DLedzianowski/badanie-ogniw-projekt-inzynierski/hardware/PCB/models/pin_jumper_2.54mm.step

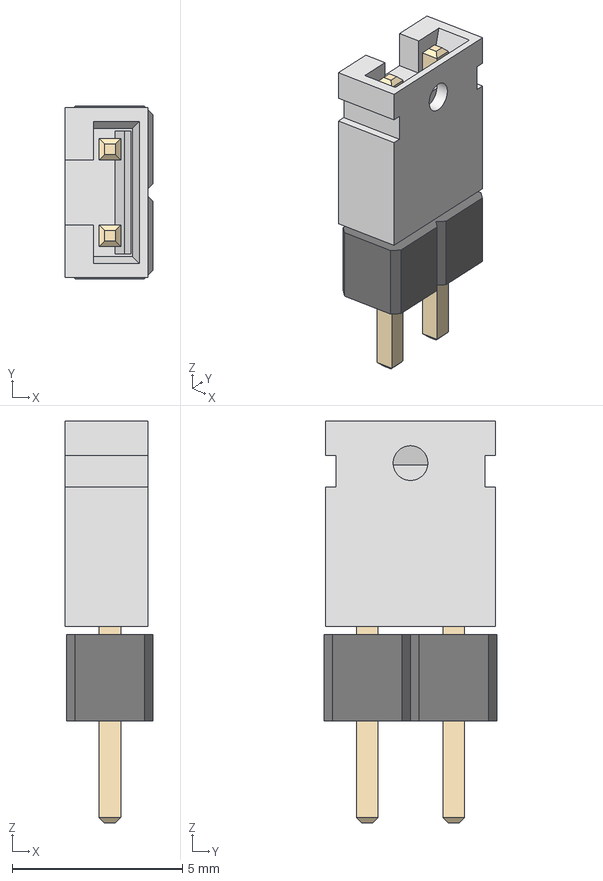
[picture p1: CAD file, 2025-12-05]
hardware/PCB/models/pin_jumper_2.54mm.step
2.59 x 5.08 x 11.8 mm
26m5017_142270-1
PinHeader_1x02_P254mm_Vertical
