DLedzianowski/badanie-ogniw-projekt-inzynierski/hardware/PCB/models/Fuse Holder.step

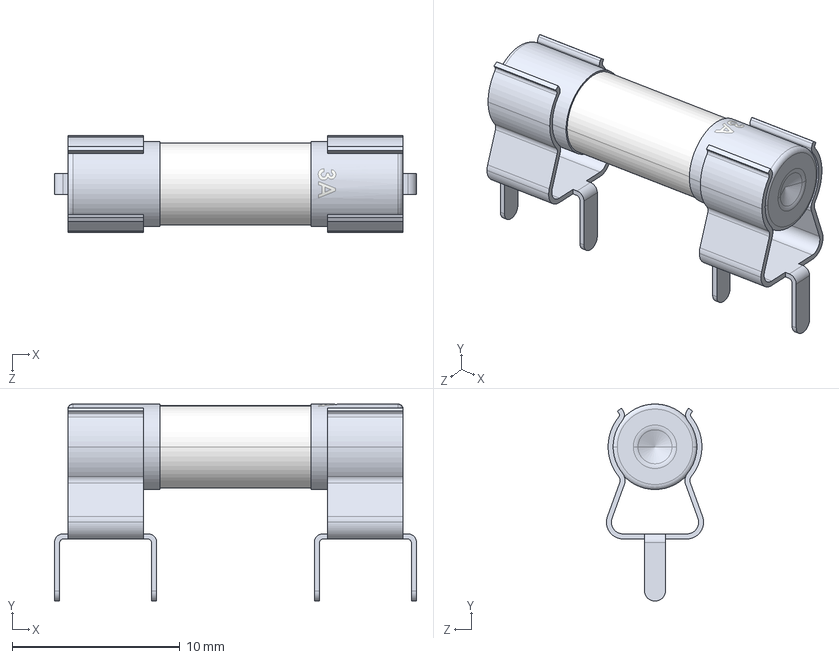
[picture p2: CAD file, 2025-12-04]
hardware/PCB/models/Fuse Holder.step
21.6 x 11.8 x 5.80 mm
Fuse Clip x 2
3A Fuse
