DLedzianowski/badanie-ogniw-projekt-inzynierski/hardware/PCB/inz.kicad_pcb

## KiCad design hardware/PCB/inz.kicad_pcb (2026-01-27)

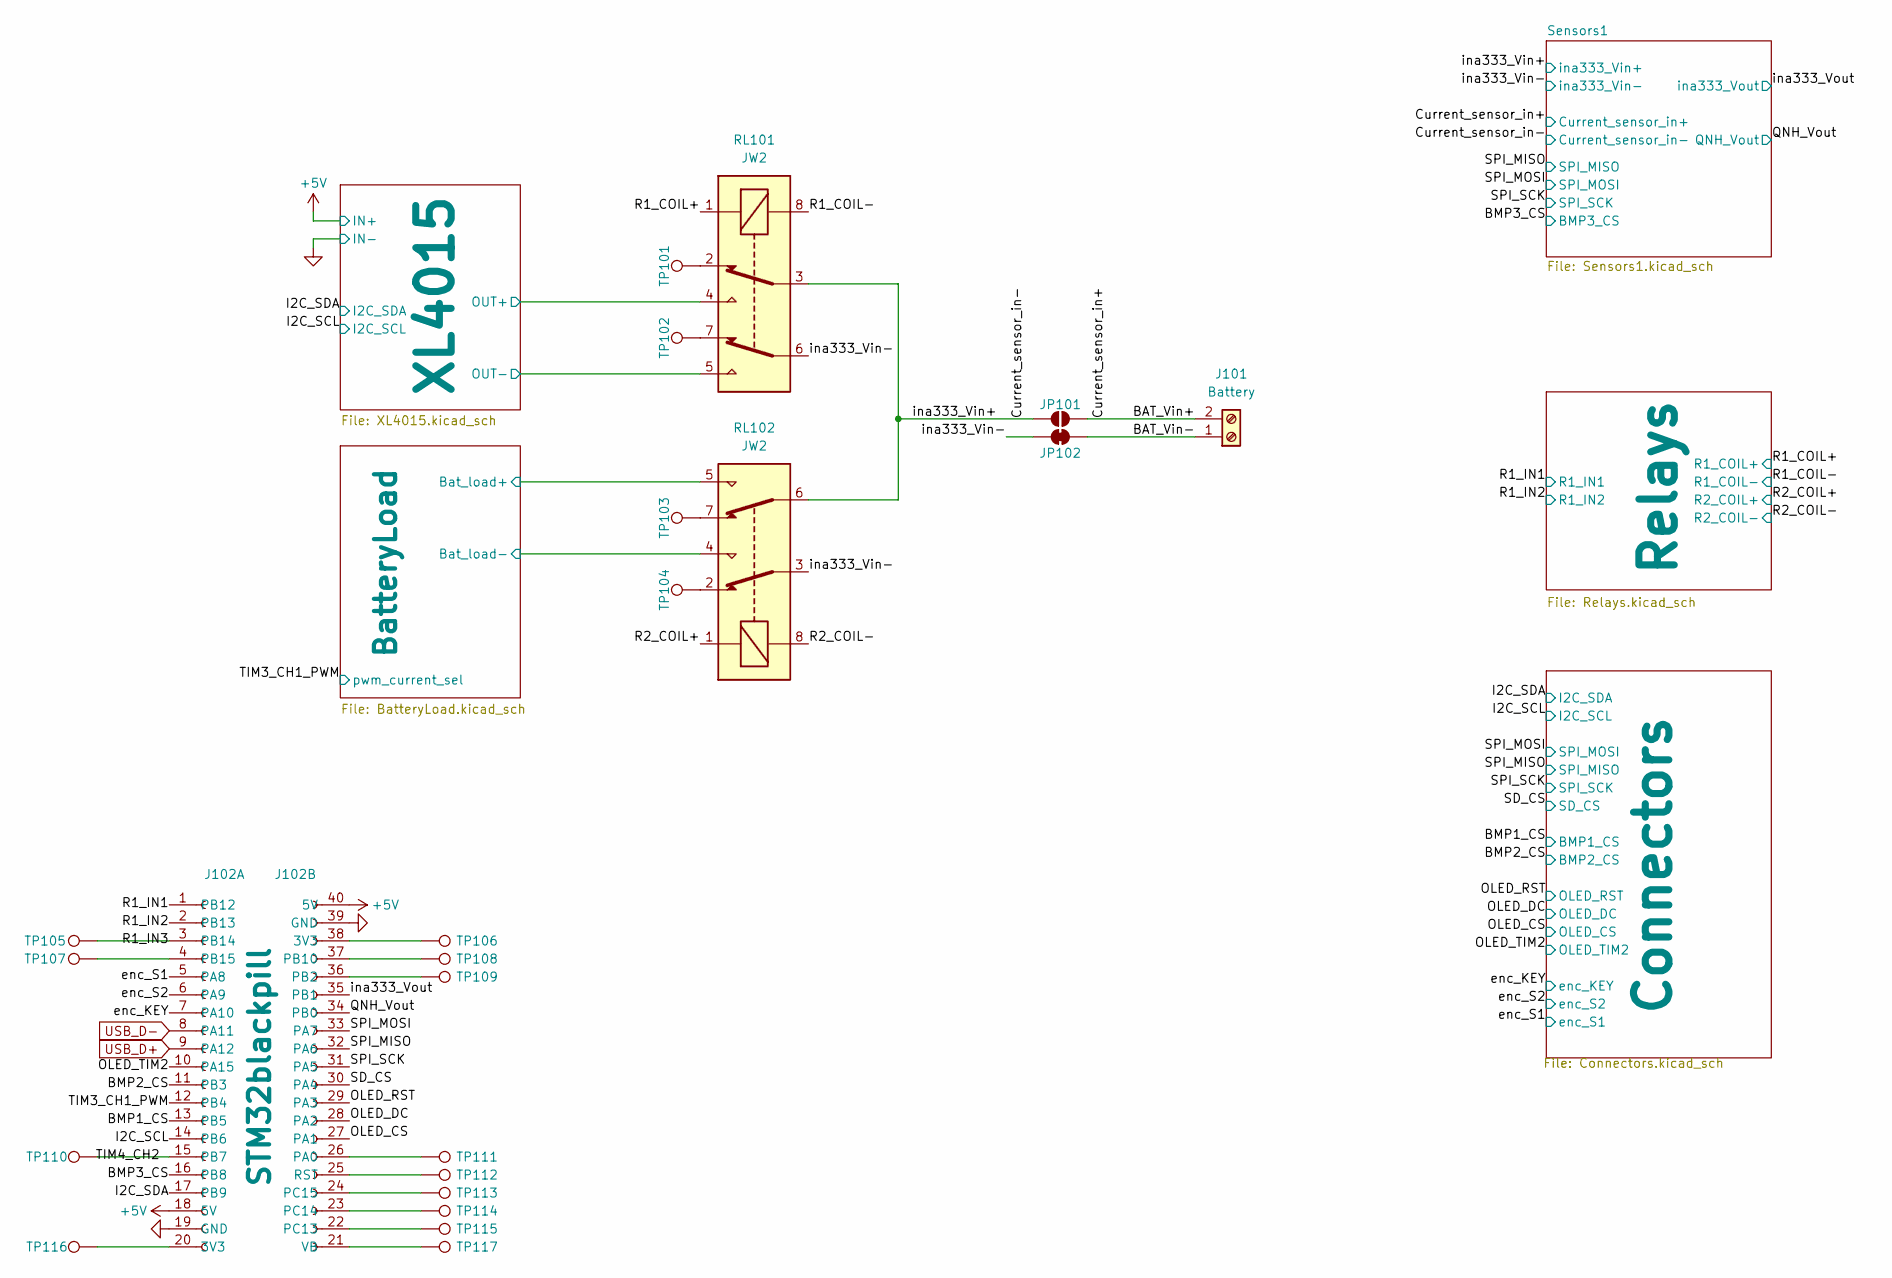
[picture p3: schematic inz.kicad_sch, Stanowisko do badania parametrów pracy ogniw Li-Ion Li-Pol]

Parts:
J101: Battery; TerminalBlock_Phoenix_MKDS-1,5-2_1x02_P5.00mm_Horizontal
J102: STM32blackpill; MFR Part ICSockets-40P; JLCPCB Part C2332
JP101: SolderJumper_2_Open; SolderJumper-2_P1.3mm_Open_TrianglePad1.0x1.5mm
JP102: Jumper_2_Bridged; PinHeader_1x02_P2.54mm_Vertical
RL101, RL102: JW2; Relay_DPDT_Panasonic_JW2; MFR Part JW2SN-DC5V
TP101, TP102, TP103, TP104, TP105, TP106, TP107, TP108, TP109, TP110, TP111, TP112, TP113, TP114, TP115, TP116, TP117: TestPoint; TestPoint_THTPad_D1.5mm_Drill0.7mm

Connections:
+5V: J102.18 (5V), J102.40 (5V), RL101.1, RL102.1; also elsewhere on the board
/BAT_Vin+: J101.2, JP101.1 (A); also elsewhere on the board
/BAT_Vin-: J101.1, JP102.2 (B)
/BMP1_CS: J102.13 (PB5); also elsewhere on the board
/BMP2_CS: J102.11 (PB3); also elsewhere on the board
/BMP3_CS: J102.16 (PB8); also elsewhere on the board
/BatteryLoad/Bat_load+: RL102.5; also elsewhere on the board
/Current_sensor_in-: JP101.2 (B), RL101.3, RL102.6; also elsewhere on the board
/I2C_SCL: J102.14 (PB6); also elsewhere on the board
/I2C_SDA: J102.17 (PB9); also elsewhere on the board
/OLED_CS: J102.27 (PA1); also elsewhere on the board
/OLED_DC: J102.28 (PA2); also elsewhere on the board
/OLED_RST: J102.29 (PA3); also elsewhere on the board
/OLED_TIM2: J102.10 (PA15); also elsewhere on the board
/QNH_Vout: J102.34 (PB0); also elsewhere on the board
/R1_COIL-: RL101.8; also elsewhere on the board
/R1_IN1: J102.1 (PB12); also elsewhere on the board
/R1_IN2: J102.2 (PB13); also elsewhere on the board
/R1_IN3: J102.3 (PB14), TP105.1
/R2_COIL-: RL102.8; also elsewhere on the board
/SD_CS: J102.30 (PA4); also elsewhere on the board
/SPI_MISO: J102.32 (PA6); also elsewhere on the board
/SPI_MOSI: J102.33 (PA7); also elsewhere on the board
/SPI_SCK: J102.31 (PA5); also elsewhere on the board
/TIM3_CH1_PWM: J102.12 (PB4); also elsewhere on the board
/TIM4_CH2: J102.15 (PB7), TP110.1
/XL4015/OUT+: RL101.4; also elsewhere on the board
/XL4015/OUT-: RL101.5; also elsewhere on the board
/enc_KEY: J102.7 (PA10); also elsewhere on the board
/enc_S1: J102.5 (PA8); also elsewhere on the board
/enc_S2: J102.6 (PA9); also elsewhere on the board
/ina333_Vin-: JP102.1 (A), RL101.6, RL102.3; also elsewhere on the board
/ina333_Vout: J102.35 (PB1); also elsewhere on the board
GND: J102.19 (GND), J102.39 (GND), RL102.4; also elsewhere on the board
unnamed: J102.20 (3V3), TP116.1
unnamed: J102.4 (PB15), TP107.1
unnamed: J102.38 (3V3), TP106.1
unnamed: J102.26 (PA0), TP111.1
unnamed: J102.36 (PB2), TP109.1
unnamed: J102.37 (PB10), TP108.1
unnamed: J102.22 (PC13), TP115.1
unnamed: J102.23 (PC14), TP114.1
unnamed: J102.24 (PC15), TP113.1
unnamed: J102.25 (RST), TP112.1
unnamed: J102.21 (VB), TP117.1
unnamed: RL101.2, TP101.1
unnamed: RL101.7, TP102.1
unnamed: RL102.2, TP104.1
unnamed: RL102.7, TP103.1
USB_D+: J102.9 (PA12); also elsewhere on the board
USB_D-: J102.8 (PA11); also elsewhere on the board

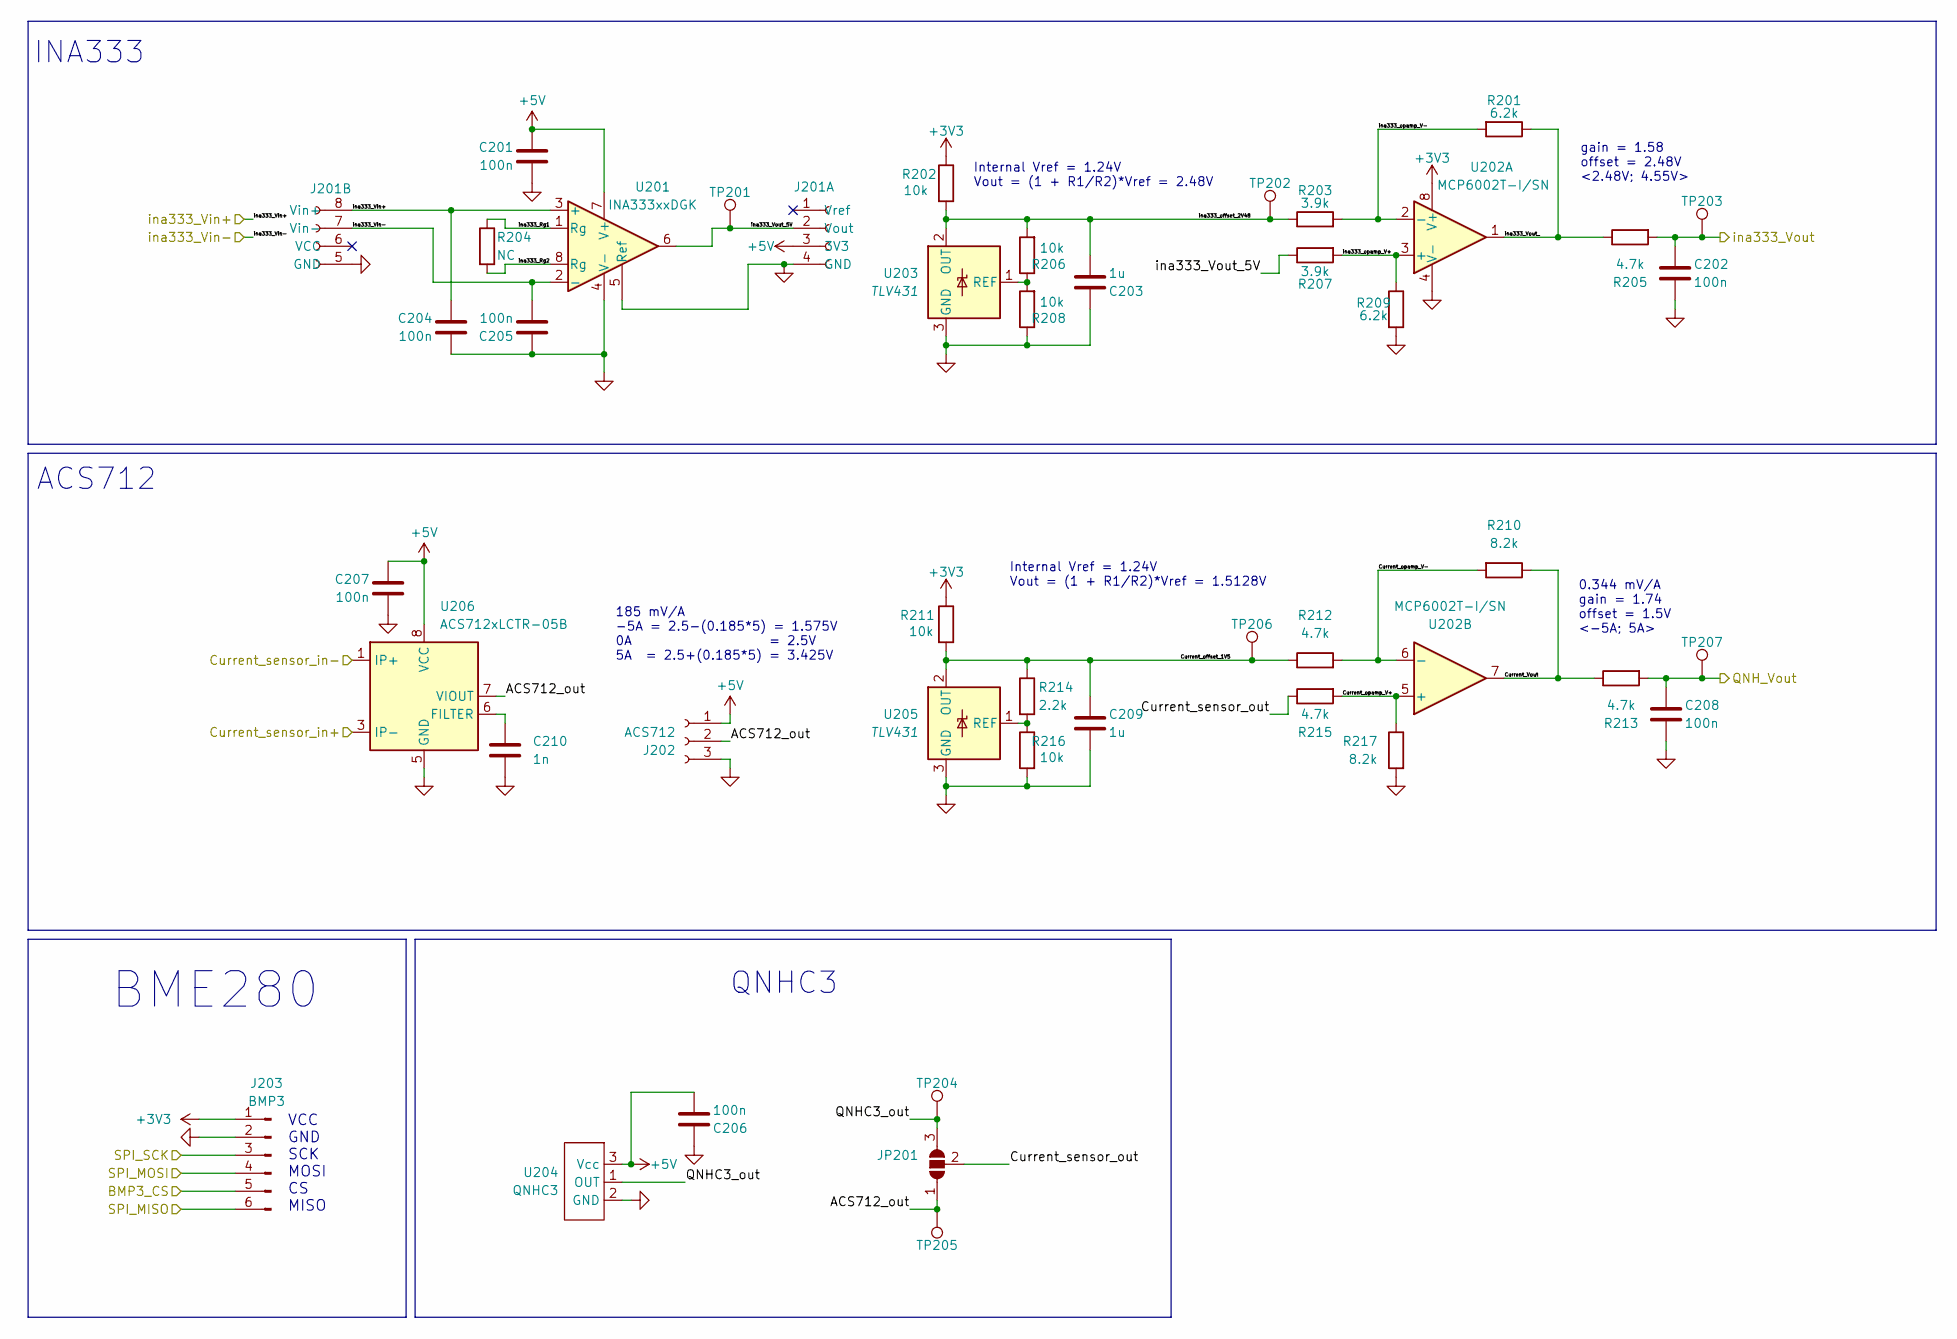
[picture p4: schematic Sensors1.kicad_sch, Stanowisko do badania parametrów pracy ogniw Li-Ion Li-Pol]

Parts:
C201, C202, C204, C205, C206, C207, C208: 100n; C_0805_2012Metric; MFR Part CL21B104KCFNNNE; JLCPCB Part C28233
C203, C209: 1u; C_0805_2012Metric; MFR Part CL21B105KBFNNNE; JLCPCB Part C28323
C210: 1n; C_0805_2012Metric; MFR Part CL21B102KBCNNNC; JLCPCB Part C46653
J201: ina333; board_ina333
J202: ACS712; PinHeader_1x03_P2.54mm_Vertical
J203: BMP3; PinHeader_1x06_P2.54mm_Vertical
JP201: SolderJumper_3_Open; SolderJumper-3_P2.0mm_Open_TrianglePad1.0x1.5mm_NumberLabels
R201, R209: 6.2k; R_0805_2012Metric; MFR Part 0805W8F6201T5E; JLCPCB Part C17767
R202, R206, R208, R211, R216: 10k; R_0805_2012Metric; MFR Part 0805W8F1002T5E; JLCPCB Part C17414
R203, R207: 3.9k; R_0805_2012Metric; MFR Part 0805W8F3901T5E; JLCPCB Part C17614
R204: NC; R_0805_2012Metric
R205, R212, R213, R215: 4.7k; R_0805_2012Metric; MFR Part 0805W8F4701T5E; JLCPCB Part C17673
R210, R217: 8.2k; R_0805_2012Metric; MFR Part 0805W8F8201T5E; JLCPCB Part C17828
R214: 2.2k; R_0805_2012Metric; MFR Part 0805W8F2201T5E; JLCPCB Part C17520
TP201, TP202, TP203, TP204, TP205, TP206, TP207: TestPoint; TestPoint_THTPad_D1.5mm_Drill0.7mm
U201: INA333xxDGK; VSSOP-8_3x3mm_P0.65mm; MFR Part INA333AIDGKT; JLCPCB Part C2057648
U202: MCP6002T-I/SN; SOIC-8_3.9x4.9mm_P1.27mm; MFR Part MCP6002T-I/SN; JLCPCB Part C7377
U203, U205: TLV431; SOT-23; MFR Part TLV431AIDBZR; JLCPCB Part C56765
U204: QNHC3
U206: ACS712xLCTR-05B; SOIC-8_3.9x4.9mm_P1.27mm; MFR Part ACS712ELCTR-05B-T; JLCPCB Part C44471

Connections:
+3V3: J203.1, R202.1, R211.1, U202.8 (V+); also elsewhere on the board
+5V: C201.1, C206.2, C207.1, J201.3 (3V3), J202.1, U201.7 (V+), U204.3 (Vcc), U206.8 (VCC); also elsewhere on the board
/BAT_Vin+: U206.3 (IP-), U206.4 (IP-); also elsewhere on the board
/BMP3_CS: J203.5; also elsewhere on the board
/Current_sensor_in-: C204.1, J201.8 (Vin+), U201.3 (+), U206.1 (IP+), U206.2 (IP+); also elsewhere on the board
/QNH_Vout: C208.1, R213.2, TP207.1; also elsewhere on the board
/SPI_MISO: J203.6; also elsewhere on the board
/SPI_MOSI: J203.4; also elsewhere on the board
/SPI_SCK: J203.3; also elsewhere on the board
/Sensors1/ACS712_out: J202.2, JP201.1 (A), TP205.1, U206.7 (VIOUT)
/Sensors1/Current_Vout: R210.1, R213.1, U202.7
/Sensors1/Current_offset_1V5: C209.1, R211.2, R212.1, R214.1, TP206.1, U205.2 (OUT)
/Sensors1/Current_opamp_V+: R215.2, R217.1, U202.5 (+)
/Sensors1/Current_opamp_V-: R210.2, R212.2, U202.6 (-)
/Sensors1/Current_sensor_out: JP201.2 (C), R215.1
/Sensors1/QNHC3_out: JP201.3 (B), TP204.1, U204.1 (OUT)
/Sensors1/ina333_Rg1: R204.1, U201.1 (Rg)
/Sensors1/ina333_Rg2: R204.2, U201.8 (Rg)
/Sensors1/ina333_Vout_: R201.1, R205.1, U202.1
/Sensors1/ina333_Vout_5V: J201.2 (Vout), R207.1, TP201.1, U201.6
/Sensors1/ina333_offset_2V48: C203.2, R202.2, R203.1, R206.2, TP202.1, U203.2 (OUT)
/Sensors1/ina333_opamp_V+: R207.2, R209.1, U202.3 (+)
/Sensors1/ina333_opamp_V-: R201.2, R203.2, U202.2 (-)
/ina333_Vin-: C205.2, J201.7 (Vin-), U201.2 (-); also elsewhere on the board
/ina333_Vout: C202.1, R205.2, TP203.1; also elsewhere on the board
GND: C201.2, C202.2, C203.1, C204.2, C205.1, C206.1, C207.2, C208.2, C209.2, C210.2, J201.4 (GND), J201.5 (GND), J202.3, J203.2, R208.1, R209.2, R216.2, R217.2, U201.4 (V-), U201.5 (Ref), U202.4 (V-), U203.3 (GND), U204.2 (GND), U205.3 (GND), U206.5 (GND); also elsewhere on the board
unnamed: R206.1, R208.2, U203.1 (REF)
unnamed: R214.2, R216.1, U205.1 (REF)
unnamed: C210.1, U206.6 (FILTER)

Notes on the sheet:
BME280
185 mV/A -5A = 2.5-(0.185*5) = 1.575V 0A = 2.5V 5A = 2.5+(0.185*5) = 3.425V
Internal Vref = 1.24V Vout = (1 + R1/R2)*Vref = 2.48V
gain = 1.58 offset = 2.48V <2.48V; 4.55V>
VCC GND SCK MOSI CS MISO
QNHC3
INA333
ACS712
Internal Vref = 1.24V Vout = (1 + R1/R2)*Vref = 1.5128V
0.344 mV/A gain = 1.74 offset = 1.5V <-5A; 5A>

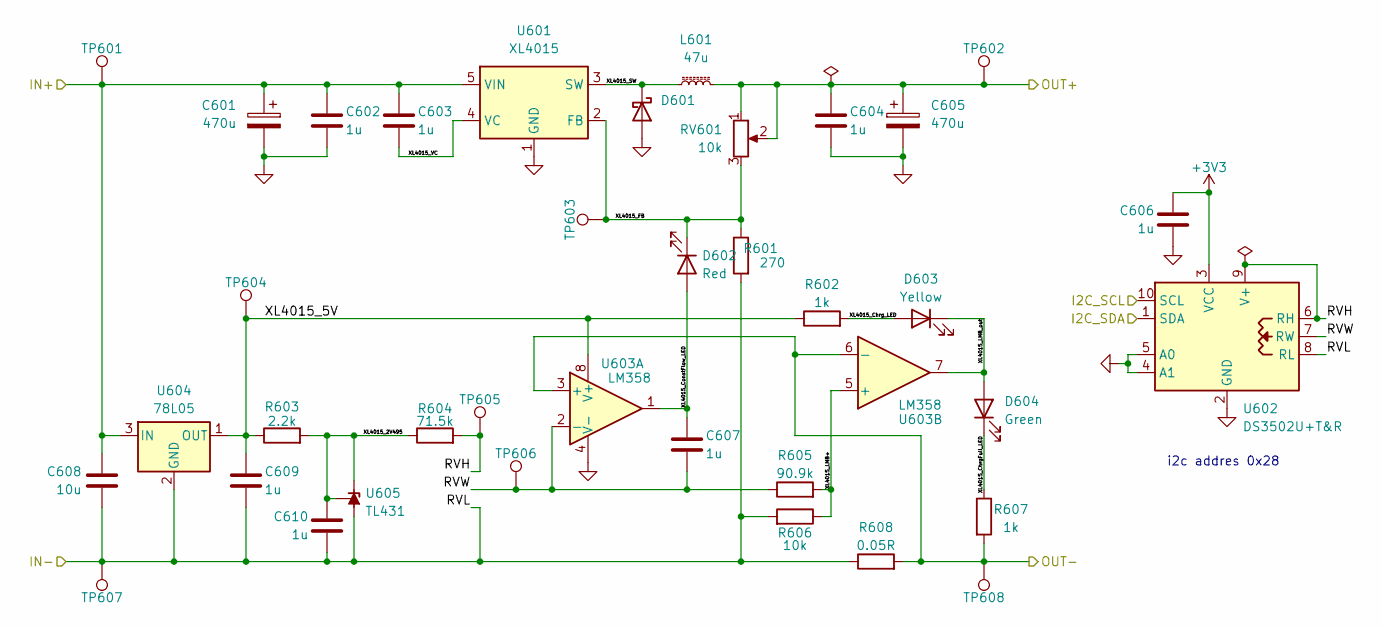
[picture p5: schematic XL4015.kicad_sch, Stanowisko do badania parametrów pracy ogniw Li-Ion Li-Pol]

Parts:
C601, C605: 470u; C_Elec_10x10.2; MFR Part RVT1E471M1010; JLCPCB Part C3351
C602, C603, C604, C606, C607, C609, C610: 1u; C_0805_2012Metric; MFR Part CL21B105KBFNNNE; JLCPCB Part C28323
C608: 10u; C_1206_3216Metric; MFR Part CL31A106KOHNNNE; JLCPCB Part C1849
D601: MBRD1045; D_SMA; MFR Part C22452; JLCPCB Part C22452
D602: Red; LED_0805_2012Metric; MFR Part NCD0805R1; JLCPCB Part C84256
D603: Yellow; LED_0805_2012Metric; MFR Part KT-0805Y; JLCPCB Part C2296
D604: Green; LED_0805_2012Metric; MFR Part KT-0805G; JLCPCB Part C2297
L601: 47u; L_Toroid_Vertical_L16.0mm_W8.0mm_P7.62mm; MFR Part XR050125TS470MVL8; JLCPCB Part C18213949
R601: 270; R_0805_2012Metric; MFR Part 0805W8F2700T5E; JLCPCB Part C17590
R602, R607: 1k; R_0805_2012Metric; MFR Part 0805W8F1001T5E; JLCPCB Part C17513
R603: 2.2k; R_0805_2012Metric; MFR Part 0805W8F2201T5E; JLCPCB Part C17520
R604: 71.5k; R_0805_2012Metric; MFR Part 0805W8F7152T5E; JLCPCB Part C17811
R605: 90.9k; R_0805_2012Metric; MFR Part 0805W8F9092T5E; JLCPCB Part C17860
R606: 10k; R_0805_2012Metric; MFR Part 0805W8F1002T5E; JLCPCB Part C17414
R608: 0.05R; R_2512_6332Metric; MFR Part 25121WF500MT4E; JLCPCB Part C127698
RV601: 10k; Potentiometer_Bourns_3299W_Vertical
TP601, TP602, TP603, TP604, TP605, TP606, TP607, TP608: TestPoint; TestPoint_THTPad_D1.5mm_Drill0.7mm
U601: XL4015; TO-263-5_TabPin3; MFR Part XL4015E1; JLCPCB Part C51661
U602: DS3502U+T&R; TSSOP-10_3x3mm_P0.5mm; MFR Part DS3502U+T&R; JLCPCB Part C2649363
U603: LM358; SOIC-8_3.9x4.9mm_P1.27mm; MFR Part LM358DR2G; JLCPCB Part C7950
U604: 78L05; SOT-89-3; MFR Part 78L05G-AB3-R; JLCPCB Part C71136
U605: TL431; SOT-23-3; MFR Part TL431BQDBZR; JLCPCB Part C190245

Connections:
+3V3: C606.1, U602.3 (VCC); also elsewhere on the board
+5V: C601.1, C602.1, C603.1, C608.1, TP601.1, U601.5 (VIN), U604.3 (IN); also elsewhere on the board
/I2C_SCL: U602.10 (SCL); also elsewhere on the board
/I2C_SDA: U602.1 (SDA); also elsewhere on the board
/XL4015/OUT+: C604.1, C605.1, L601.2, RV601.1, RV601.2, TP602.1; also elsewhere on the board
/XL4015/OUT-: R607.2, R608.2, TP608.1, U603.3 (+), U603.6 (-); also elsewhere on the board
/XL4015/RVH: R604.2, TP605.1, U602.6 (RH), U602.9 (V+)
/XL4015/RVW: C607.2, R605.1, TP606.1, U602.7 (RW), U603.2 (-)
/XL4015/XL4015_2V495: C610.1, R603.2, R604.1, U605.1 (K), U605.2 (REF)
/XL4015/XL4015_5V: C609.1, R602.1, R603.1, TP604.1, U603.8 (V+), U604.1 (OUT)
/XL4015/XL4015_ChrgFull_LED: D604.1 (K), R607.1
/XL4015/XL4015_Chrg_LED: D603.2 (A), R602.2
/XL4015/XL4015_ConstFlow_LED: C607.1, D602.2 (A), U603.1
/XL4015/XL4015_FB: D602.1 (K), R601.1, RV601.3, TP603.1, U601.2 (FB)
/XL4015/XL4015_LMB+: R605.2, R606.1, U603.5 (+)
/XL4015/XL4015_LMB_out: D603.1 (K), D604.2 (A), U603.7
/XL4015/XL4015_SW: D601.1 (K), L601.1, U601.3 (SW)
/XL4015/XL4015_VC: C603.2, U601.4 (VC)
GND: C601.2, C602.2, C604.2, C605.2, C606.2, C608.2, C609.2, C610.2, D601.2 (A), R601.2, R606.2, R608.1, TP607.1, U601.1 (GND), U602.2 (GND), U602.4 (A1), U602.5 (A0), U602.8 (RL), U603.4 (V-), U604.2 (GND), U605.3 (A); also elsewhere on the board

Notes on the sheet:
i2c addres 0x28

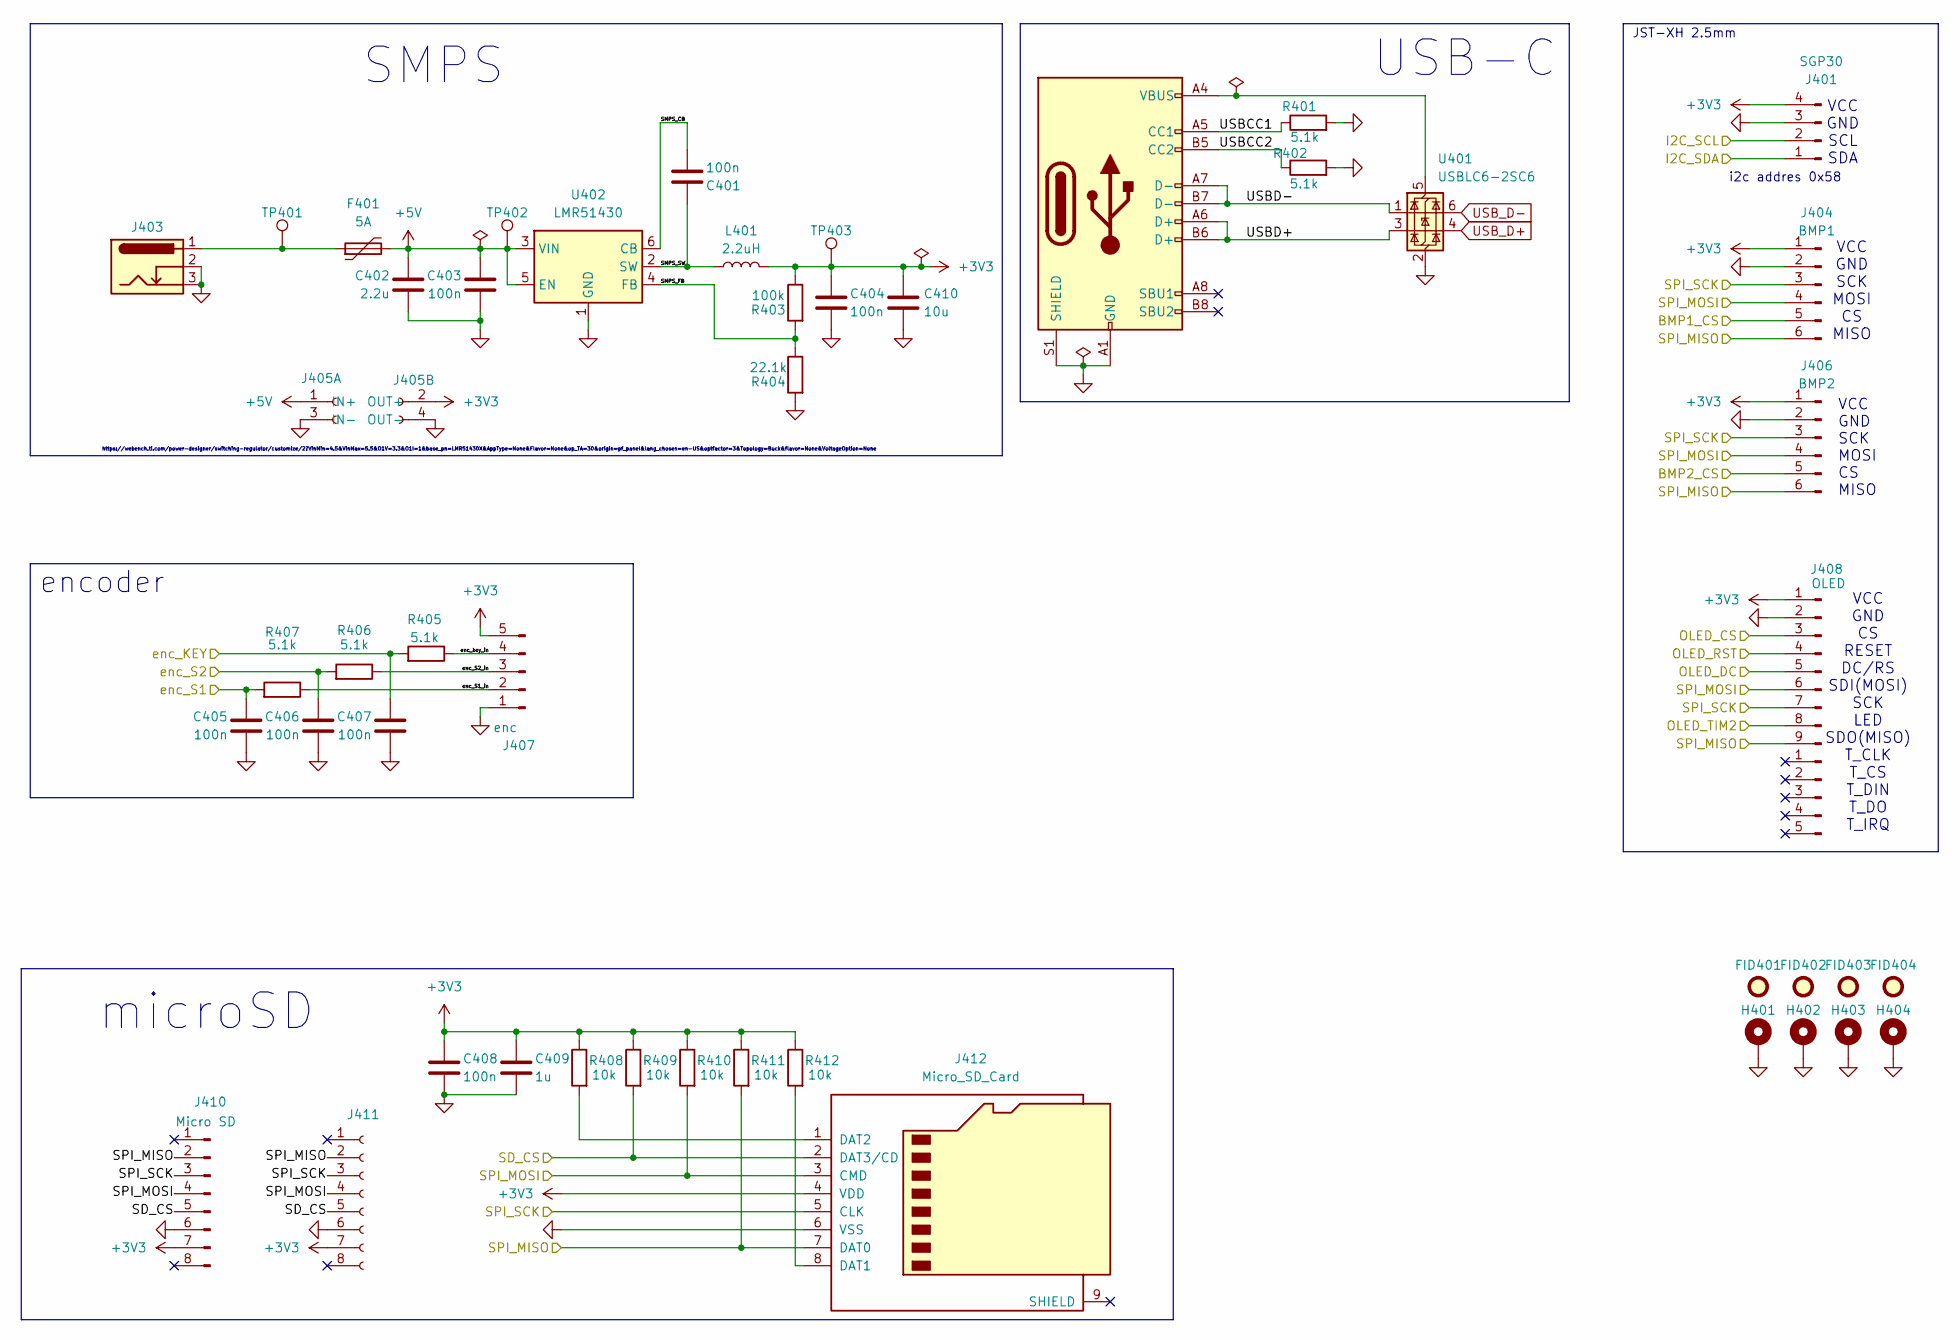
[picture p6: schematic Connectors.kicad_sch, Stanowisko do badania parametrów pracy ogniw Li-Ion Li-Pol]

Parts:
C401, C405, C406, C407, C408: 100n; C_0805_2012Metric; MFR Part CL21B104KCFNNNE; JLCPCB Part C28233
C402: 2.2u; C_0805_2012Metric; MFR Part CL21A225KBQNNNE; JLCPCB Part C377773
C403, C404: 100n; C_0805_2012Metric; MFR Part CL21B104KBCNNNC; JLCPCB Part C1711
C409: 1u; C_0805_2012Metric; MFR Part CL21B105KBFNNNE; JLCPCB Part C28323
C410: 10u; C_1206_3216Metric; MFR Part CL31A106KOHNNNE; JLCPCB Part C1849
F401: 5A; Fuseholder_Clip-5x20mm
FID401, FID402, FID403, FID404: Fiducial; Fiducial_1mm_Mask2mm
H401, H402, H403, H404: MountingHole_Pad; MountingHole_3.2mm_M3_Pad
J401: SGP30; JST_XH_B4B-XH-A_1x04_P2.50mm_Vertical; MFR Part B4B-XH-A(LF)(SN); JLCPCB Part C144395
J402: USBC; USB_C_16P; MFR Part TYPE-C-31-M-48; JLCPCB Part C47817612
J403: 5V; BarrelJack_GCT_DCJ200-10-A_Horizontal; MFR Part DC-005H-D020; JLCPCB Part C5155559
J404: BMP1; JST_XH_B6B-XH-A_1x06_P2.50mm_Vertical; MFR Part B6B-XH-A(LF)(SN); JLCPCB Part C144397
J405: board_step-down
J406: BMP2; JST_XH_B6B-XH-A_1x06_P2.50mm_Vertical; MFR Part B6B-XH-A(LF)(SN); JLCPCB Part C144397
J407: enc; JST_XH_B5B-XH-A_1x05_P2.50mm_Vertical; MFR Part B5B-XH-A(LF)(SN); JLCPCB Part C157991
J408: OLED; JST_XH_B9B-XH-A_1x09_P2.50mm_Vertical; MFR Part B9B-XH-A(LF)(SN); JLCPCB Part C157966
J409: Conn_01x05_Pin; JST_XH_B5B-XH-A_1x05_P2.50mm_Vertical
J410: Micro SD; board_smd_sd
J411: Micro SD2; PinHeader_1x08_P2.54mm_Vertical
J412: Micro_SD_Card; microSD; MFR Part TF-021B-H265; JLCPCB Part C498185
L401: 2.2uH; SMD,10.4x10.3mm; MFR Part SXN(Shun Xiang Nuo Elec); JLCPCB Part C10164
R401, R402, R405, R406, R407: 5.1k; R_0805_2012Metric; MFR Part 0805W8F5101T5E; JLCPCB Part C27834
R403: 100k; R_0805_2012Metric; MFR Part 0805W8F1003T5E; JLCPCB Part C149504
R404: 22.1k; R_0805_2012Metric; MFR Part 0805W8F2212T5E; JLCPCB Part C17552
R408, R409, R410, R411, R412: 10k; R_0805_2012Metric; MFR Part 0805W8F1002T5E; JLCPCB Part C17414
TP401, TP402, TP403: TestPoint; TestPoint_THTPad_D1.5mm_Drill0.7mm
U401: USBLC6-2SC6; SOT-23-6; MFR Part USBLC6-2SC6; JLCPCB Part C7519
U402: LMR51430; SOT-23-6; MFR Part LMR51430XDDCR; JLCPCB Part C5185863

Connections:
+3V3: C404.1, C408.1, C409.1, C410.1, J401.4, J404.1, J405.2 (OUT+), J406.1, J407.5, J408.1, J410.7, J411.7, J412.4 (VDD), L401.2, R403.1, R408.1, R409.1, R410.1, R411.1, R412.1, TP403.1; also elsewhere on the board
+5V: C402.1, C403.1, F401.2, J405.1 (IN+), TP402.1, U402.3 (VIN), U402.5 (EN); also elsewhere on the board
/BMP1_CS: J404.5; also elsewhere on the board
/BMP2_CS: J406.5; also elsewhere on the board
/Connectors/SMPS_CB: C401.2, U402.6 (CB)
/Connectors/SMPS_FB: R403.2, R404.1, U402.4 (FB)
/Connectors/SMPS_SW: C401.1, L401.1, U402.2 (SW)
/Connectors/USBCC1: J402.A5 (CC1), R401.1
/Connectors/USBCC2: J402.B5 (CC2), R402.1
/Connectors/USBD+: J402.A6 (D+), J402.B6 (D+), U401.3 (I/O2)
/Connectors/USBD-: J402.A7 (D-), J402.B7 (D-), U401.1 (I/O1)
/Connectors/enc_S1_in: J407.2, R407.1
/Connectors/enc_S2_in: J407.3, R406.1
/Connectors/enc_key_in: J407.4, R405.1
/I2C_SCL: J401.2; also elsewhere on the board
/I2C_SDA: J401.1; also elsewhere on the board
/OLED_CS: J408.3; also elsewhere on the board
/OLED_DC: J408.5; also elsewhere on the board
/OLED_RST: J408.4; also elsewhere on the board
/OLED_TIM2: J408.8; also elsewhere on the board
/SD_CS: J410.5, J411.5, J412.2 (DAT3/CD), R409.2; also elsewhere on the board
/SPI_MISO: J404.6, J406.6, J408.9, J410.2, J411.2, J412.7 (DAT0), R411.2; also elsewhere on the board
/SPI_MOSI: J404.4, J406.4, J408.6, J410.4, J411.4, J412.3 (CMD), R410.2; also elsewhere on the board
/SPI_SCK: J404.3, J406.3, J408.7, J410.3, J411.3, J412.5 (CLK); also elsewhere on the board
/enc_KEY: C407.1, R405.2; also elsewhere on the board
/enc_S1: C405.1, R407.2; also elsewhere on the board
/enc_S2: C406.1, R406.2; also elsewhere on the board
GND: C402.2, C403.2, C404.2, C405.2, C406.2, C407.2, C408.2, C409.2, C410.2, H401.1, H402.1, H403.1, H404.1, J401.3, J402.A1 (GND), J402.A12 (GND), J402.B1 (GND), J402.B12 (GND), J402.S1 (SHIELD), J403.2, J403.3, J404.2, J405.3 (IN-), J405.4 (OUT-), J406.2, J407.1, J408.2, J410.6, J411.6, J412.6 (VSS), R401.2, R402.2, R404.2, U401.2 (GND), U402.1 (GND); also elsewhere on the board
unnamed: F401.1, J403.1, TP401.1
unnamed: J412.8 (DAT1), R412.2
unnamed: J412.1 (DAT2), R408.2
unnamed: J402.A4 (VBUS), J402.A9 (VBUS), J402.B4 (VBUS), J402.B9 (VBUS), U401.5 (VBUS)
USB_D+: U401.4 (I/O2); also elsewhere on the board
USB_D-: U401.6 (I/O1); also elsewhere on the board

Notes on the sheet:
VCC GND SCL SDA
SMPS
microSD
VCC GND SCK MOSI CS MISO
i2c addres 0x58
USB-C
encoder
https://webench.ti.com/power-designer/switching-regulator/customize/2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
JST-XH 2.5mm
VCC GND CS RESET DC/RS SDI(MOSI) SCK LED SDO(MISO) T_CLK T_CS T_DIN T_DO T_IRQ
VCC GND SCK MOSI CS MISO

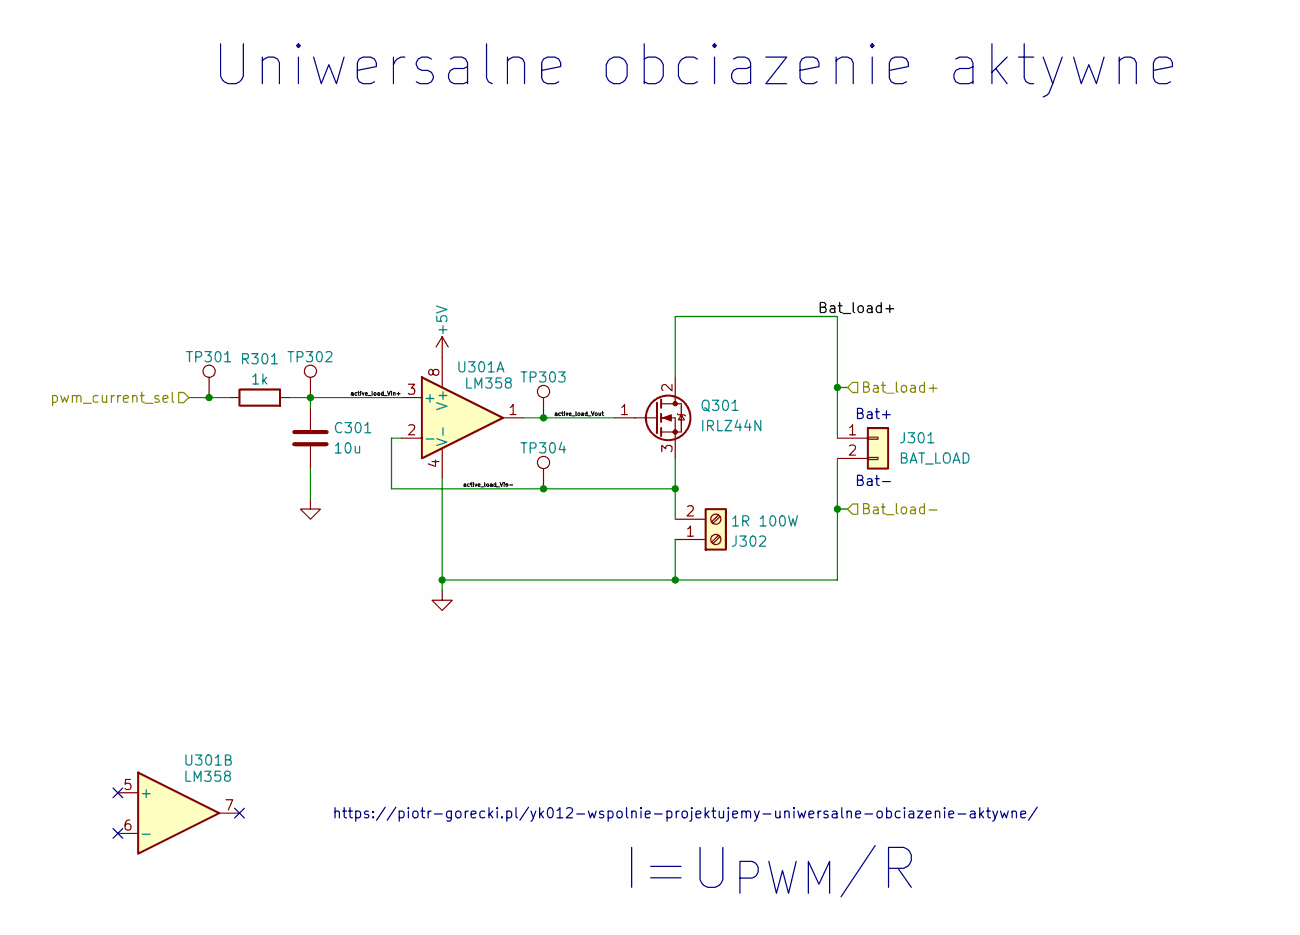
[picture p7: schematic BatteryLoad.kicad_sch, Stanowisko do badania parametrów pracy ogniw Li-Ion Li-Pol]

Parts:
C301: 10u; C_1206_3216Metric; MFR Part CL31A106KOHNNNE; JLCPCB Part C1849
J301: BAT_LOAD; TerminalBlock_MaiXu_MX126-5.0-02P_1x02_P5.00mm
J302: 1R 100W; TerminalBlock_Phoenix_MKDS-1,5-2_1x02_P5.00mm_Horizontal
Q301: IRLZ44N; TO-220-3_Vertical; MFR Part IRLZ44NPBF; JLCPCB Part C38774
R301: 1k; R_0805_2012Metric; MFR Part 0805W8F1001T5E; JLCPCB Part C17513
TP301, TP302, TP303, TP304: TestPoint; TestPoint_THTPad_D1.5mm_Drill0.7mm
U301: LM358; SOIC-8_3.9x4.9mm_P1.27mm; MFR Part LM358DR2G; JLCPCB Part C7950

Connections:
+5V: U301.8 (V+); also elsewhere on the board
/BatteryLoad/Bat_load+: J301.1, Q301.2 (D); also elsewhere on the board
/BatteryLoad/active_load_Vin+: C301.1, R301.2, TP302.1, U301.3 (+)
/BatteryLoad/active_load_Vin-: J302.2, Q301.3 (S), TP304.1, U301.2 (-)
/BatteryLoad/active_load_Vout: Q301.1 (G), TP303.1, U301.1
/TIM3_CH1_PWM: R301.1, TP301.1; also elsewhere on the board
GND: C301.2, J301.2, J302.1, U301.4 (V-); also elsewhere on the board

Notes on the sheet:
Uniwersalne obciazenie aktywne
Bat-
I=U_{PWM}/R
https://piotr-gorecki.pl/yk012-wspolnie-projektujemy-uniwersalne-obciazenie-aktywne/
Bat+

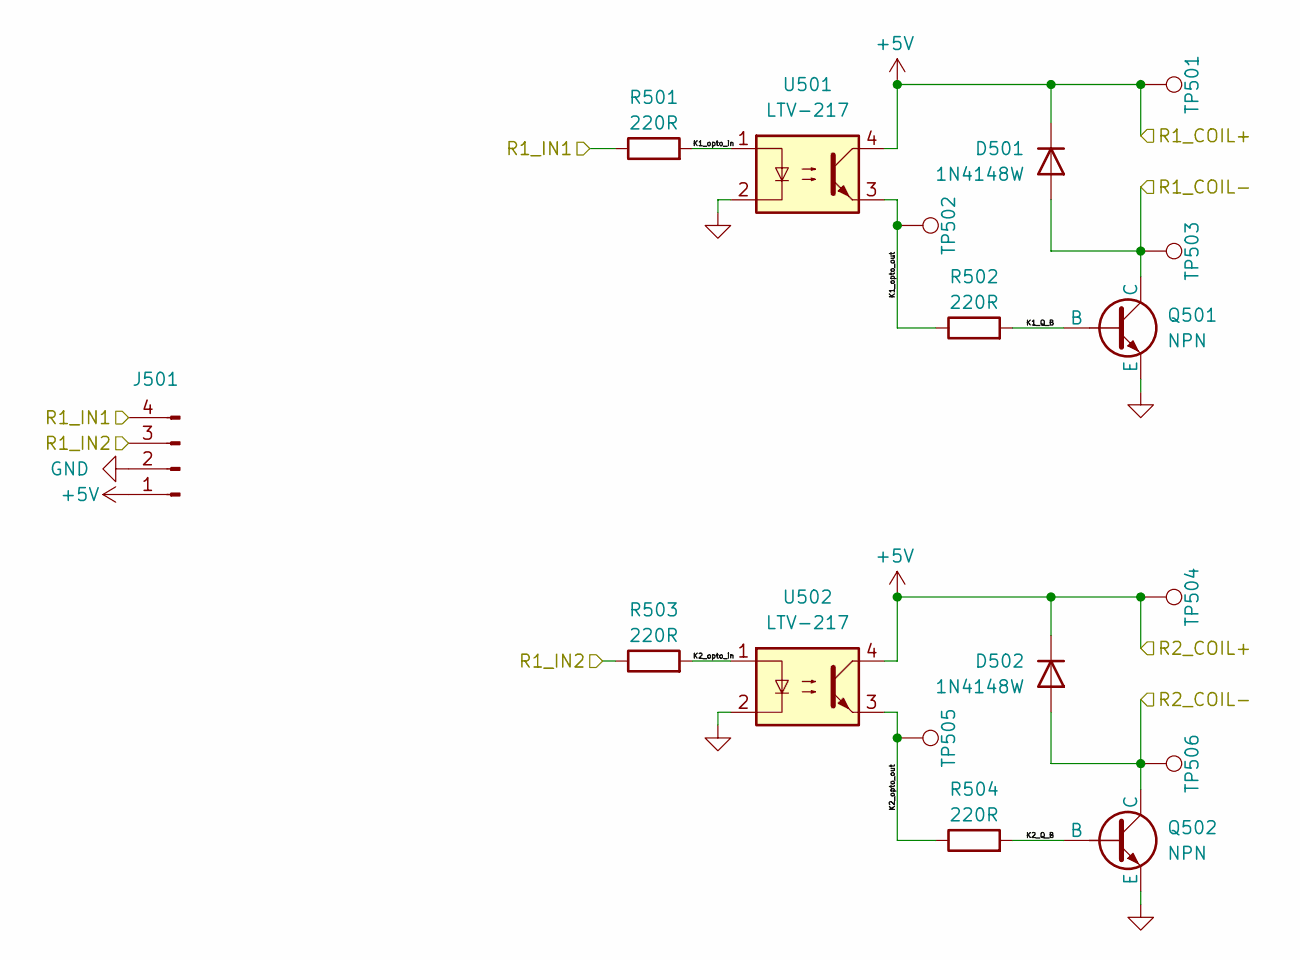
[picture p8: schematic Relays.kicad_sch, Stanowisko do badania parametrów pracy ogniw Li-Ion Li-Pol]

Parts:
D501, D502: 1N4148W; D_SOD-123; MFR Part 1N4148W; JLCPCB Part C81598
J501: Conn_01x04_Pin; PinHeader_1x04_P2.54mm_Vertical
Q501, Q502: NPN; SOT-23; MFR Part MMBT3904(RANGE:100-300); JLCPCB Part C20526
R501, R502, R503, R504: 220R; R_0805_2012Metric; MFR Part 0805W8F2200T5E; JLCPCB Part C17557
TP501, TP502, TP503, TP504, TP505, TP506: TestPoint; TestPoint_THTPad_D1.5mm_Drill0.7mm
U501, U502: LTV-217; SOP-4_4.4x2.6mm_P1.27mm; MFR Part LTV-217-B-G; JLCPCB Part C115450

Connections:
+5V: D501.1 (K), D502.1 (K), J501.1, TP501.1, TP504.1, U501.4, U502.4; also elsewhere on the board
/R1_COIL-: D501.2 (A), Q501.1 (C), TP503.1; also elsewhere on the board
/R1_IN1: J501.4, R501.1; also elsewhere on the board
/R1_IN2: J501.3, R503.1; also elsewhere on the board
/R2_COIL-: D502.2 (A), Q502.1 (C), TP506.1; also elsewhere on the board
/Relays/K1_Q_B: Q501.2 (B), R502.2
/Relays/K1_opto_in: R501.2, U501.1
/Relays/K1_opto_out: R502.1, TP502.1, U501.3
/Relays/K2_Q_B: Q502.2 (B), R504.2
/Relays/K2_opto_in: R503.2, U502.1
/Relays/K2_opto_out: R504.1, TP505.1, U502.3
GND: J501.2, Q501.3 (E), Q502.3 (E), U501.2, U502.2; also elsewhere on the board

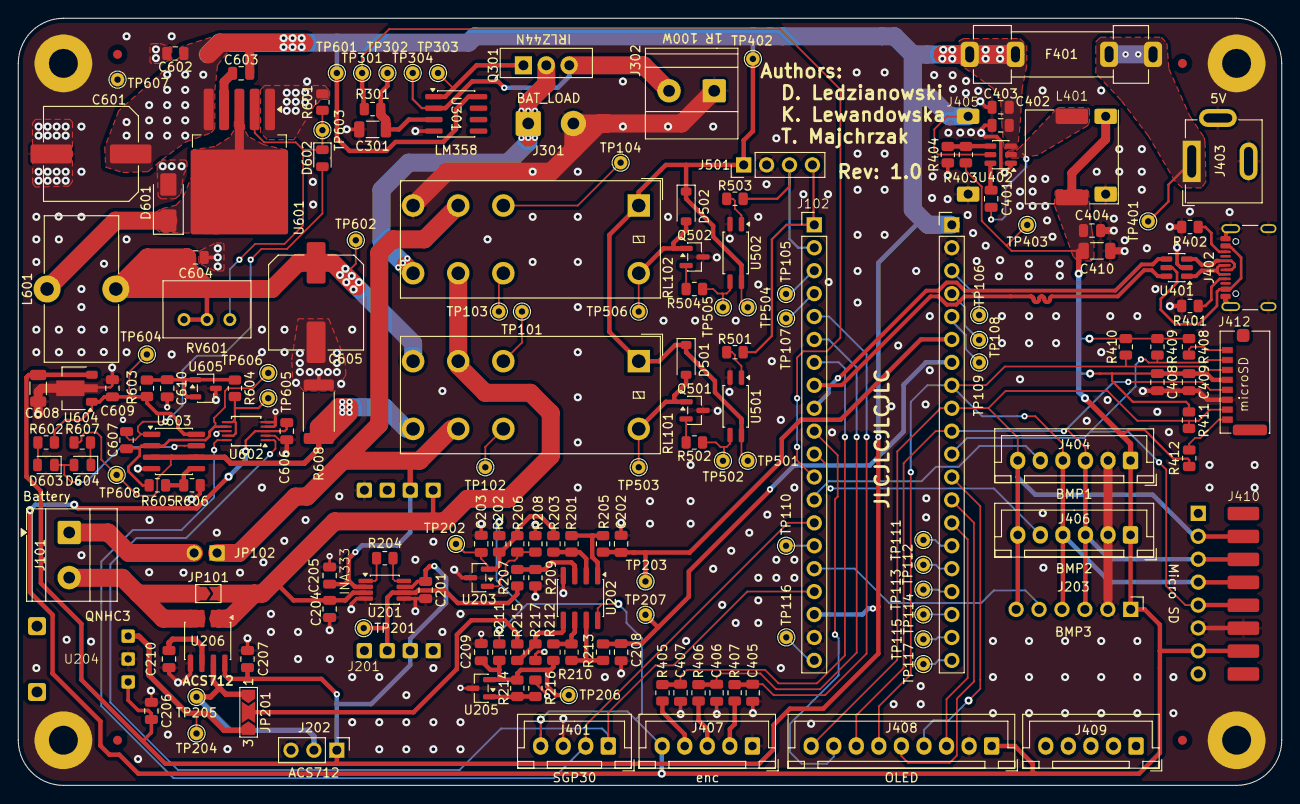
[picture p9: board inz.kicad_pcb from above]

Board: 2 copper layers, 140.0 x 85.0 mm, 180 parts (0 on the bottom side), 104 nets.
