DLedzianowski/badanie-ogniw-projekt-inzynierski/software/STM32CubeIDE/badanie-ogniw-blackpill/Core/Src/main.c

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
/* Includes ------------------------------------------------------------------*/
#include "main.h"
#include "adc.h"
#include "dma.h"
#include "fatfs.h"
#include "i2c.h"
#include "spi.h"
#include "tim.h"
#include "usb_device.h"
#include "gpio.h"

/* USER CODE BEGIN Includes */
#include "usbd_cdc_if.h"
#include "sensors/printf_to_uart.h"
#include "sensors/ILI9341_STM32_Driver.h"
#include "sensors/ILI9341_GFX.h"
#include "sensors/fonts.h"
#include "sensors/BMPXX80.h"
#include "sensors/sensirion_common.h"
#include "sensors/sgp30.h"
#include "logic/user_SDcard.h"
#include "logic/user_OLED.h"
#include "logic/user_fnc.h"

/* USER CODE END Includes */


/* USER CODE BEGIN PV */
struct state st = {
	.current_screen_type = MENU_MAIN,
	.menu_current_ptr = MENU_START,
	.sensor_current = SENSOR_FIRST,
	.battery_state = BATTERY_IDLE,  // BATTERY_IDLE = 0, BATTERY_CHARGING = 1, BATTERY_DISCHARGING = 2
	.auto_mode_current = AUTO_MODE,  // AUTO_MODE = 0, MANUAL_MODE = 1

	.screen_menu_ptr = 0,
	.screen_menu_current = 0,
	.battery_ptr = 0,
	.battery_current = 0,
	.status_ptr = 0,     // BATTERY_IDLE = 0, BATTERY_CHARGING = 1, BATTERY_DISCHARGING = 2
	.status_current = 0, // BATTERY_IDLE = 0, BATTERY_CHARGING = 1, BATTERY_DISCHARGING = 2
	.auto_mode_ptr = 0,     // AUTO_MODE = 0, MANUAL_MODE = 1
	.auto_mode_current = 0, // AUTO_MODE = 0, MANUAL_MODE = 1
	.enc_count = 0,
	.prev_enc_count = 0,
	.enc_offset = 0,
    .set_current_discharge = 0,      // prad rozłaowywania
    .set_current_discharge_prev = 0, // prad rozłaowywania
    .set_current_charge = 0,
    .set_current_charge_prev = 0,
    .get_current_charge = 0,
    .charge_end_current = 0.1,      // minimalny prad ladowania
    .charge_end_current_prev = 0.1, // minimalny prad ladowania
    .discharge_cutoff_voltage = 3.0,      // minimalne napiecie rozladowywania
    .discharge_cutoff_voltage_prev = 3.0, // minimalne napiecie rozladowywania

	.is_screen_menu = true,
	.screen_clear = true,
};
struct sensors s = {0};

const char* menu[SCREENS_MENU_NUM] = {
	"Start",
	//"Typ baterii",
	//"Prad adowania",
	"Min. prad adowania",
	"Min. napiecie roz.",
	"Prad rozadowania",
	"Status",
	"Tryb",
	"Stop"
};

const char* batteries[BATERYS_NUM] = {
	"Brak ogniwa",
	"Li-Ion",
	"Li-Pol"

};

const char* status[STATUS_NUM] = {
	"Bezczynny",
	"Ladowanie",
	"Rozadow."
};
const char* auto_mode[AUTO_MODE_NUM] = {
	"Automatyczny",
	"Jednorazowy"
};

/* USER CODE END PV */

void SystemClock_Config(void);
/**
  * @brief  The application entry point.
  * @retval int
  */
int main(void)
{

  /* MCU Configuration--------------------------------------------------------*/

  /* Reset of all peripherals, Initializes the Flash interface and the Systick. */
  HAL_Init();

  /* Configure the system clock */
  SystemClock_Config();

  /* Initialize all configured peripherals */
  MX_GPIO_Init();
  MX_DMA_Init();
  MX_ADC1_Init();
  MX_I2C1_Init();
  MX_SPI1_Init();
  MX_USB_DEVICE_Init();
  MX_TIM3_Init();
  MX_TIM4_Init();
  MX_FATFS_Init();
  MX_TIM1_Init();
  MX_TIM2_Init();
  MX_TIM11_Init();
  /* USER CODE BEGIN 2 */
	// OLED
  	HAL_GPIO_WritePin(GPIOC, GPIO_PIN_13, 0);

	ILI9341_Init();
	ILI9341_FillScreen(WHITE);

	// BMP x3
	for (uint8_t index = 0; index < BME_SENSOR_COUNT ; ++index) {
		if (!BME280_Init(&hspi1, BME280_TEMPERATURE_16BIT, BME280_PRESSURE_ULTRALOWPOWER, BME280_HUMINIDITY_ULTRAHIGH, BME280_FORCEDMODE, index)) {
			LOG_DEBUG("BMP280 sensor error\r\n");
		}
		else{
			LOG_DEBUG("BMP280 sensor ok\r\n");
		}
	}

	// SGP
	if (sgp_probe() != STATUS_OK) {
		LOG_DEBUG("SGP sensor error\r\n");
	}
	else {
		LOG_DEBUG("SGP sensor ok\r\n");
	}


	// TIMER
	HAL_TIM_Encoder_Start(&htim1, TIM_CHANNEL_ALL);
	HAL_TIM_Base_Start_IT(&htim4);
	HAL_TIM_Base_Start_IT(&htim11);
	HAL_TIM_PWM_Start(&htim3, TIM_CHANNEL_1);

	// oled options setup
	//OLED_options_init();

	LOG_DEBUG("Complete peripheral initialization\r\n");
	HAL_Delay(1000);
  	HAL_GPIO_WritePin(GPIOC, GPIO_PIN_13, 1);
  /* USER CODE END 2 */

  /* Infinite loop */
  /* USER CODE BEGIN WHILE */
	while (1)
	{
    /* USER CODE END WHILE */

    /* USER CODE BEGIN 3 */
		// stele probkowanie
		if (st._interrupt_flag == true && st.is_measurements_started == true) {
			read_sensors_data();	// batteries[BATERYS_NUM] = { jest pol a wykrywa ion

			// charging state
			handle_battery_state();

			// OLED
			OLED_manage();

			// SD
			//SDcardWriteData();

			// Transmit over usb
			LOG_DATA("%u,%u,"
		             "%.2f,%ld,%.2f,%ld,%.2f,%ld,%.2f,"
		             "%.2f,%.2f,%.2f,%.2f,"
		             "%i,%i,%i,%i,%i,%i\r\n",
					s.tvoc_ppb, s.co2_eq_ppm,
					s.BME280temperature[0], s.BME280pressure[0], s.BME280temperature[1], s.BME280pressure[1], s.BME280temperature[2], s.BME280pressure[2], s.BME280humidity,
					s.voltage, s.current, st.get_current_charge, st.set_current_discharge,
					st.battery_state, st.auto_mode_current, st.battery_current, st.is_measurements_started, st.discharge_relay, st.charge_relay);

			st._interrupt_flag = false;
		}
		// menu poczatkowe
		else if (st.is_measurements_started == false || st.screen_clear == true) {
			OLED_manage();
		}
		if (st._interrupt_flag == true && st.current_screen_type == SCREEN_MENU && st.menu_current == MENU_MAIN) {
			st._interrupt_flag = false;
			display_bottom_bar();
		}
	}
  /* USER CODE END 3 */
}

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
/* USER CODE BEGIN 4 */
void HAL_TIM_PeriodElapsedCallback(TIM_HandleTypeDef *htim) {
	// encoder
	if (htim->Instance == TIM11) {
	    int16_t raw = (int16_t)__HAL_TIM_GET_COUNTER(&htim1);
	    int16_t  pos = raw >> 2;   // /4

	    if (pos != st.enc_count)
	    {
	        st.enc_count = pos;
	        st.screen_clear = true;
	    }
	}
	// main loop sensor data
	if (htim == &htim4 /*&& st.is_measurements_started == true*/){
		if (st._interrupt_flag == true){
			LOG_DEBUG("Flaga _interrupt_flag jest juz 1\r\n");
		}
		else{
			st._interrupt_flag = true;
		}
	}
}

void HAL_GPIO_EXTI_Callback(uint16_t GPIO_Pin) {
    // Encoder Button
    if (GPIO_Pin == enc_KEY_Pin) {
        static uint32_t last_press_time = 0;
        uint32_t now = HAL_GetTick();

        // debounce
        if (now - last_press_time >= 500) {
            st.is_enc_pressed = true;
            st.screen_clear = true;
            last_press_time = now;
        }
    }
    // Set battery type based on the state of PB14 and PB15 pins
    else if (GPIO_Pin == GPIO_PIN_14 || GPIO_Pin == GPIO_PIN_15) {
        BATT_state();
    }
}

/* USER CODE END 4 */
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
