DLedzianowski/badanie-ogniw-projekt-inzynierski/software/STM32CubeIDE/badanie-ogniw-blackpill/badanie-ogniw-blackpill.ioc

Mcu.UserName=STM32F411CEUx
PA0-WKUP.Signal=ADCx_IN0
PA1.GPIO_Label=oled_CS
PA1.Signal=GPIO_Output
PA10.GPIO_Label=enc_KEY
PA10.Signal=GPXTI10
PA11.Signal=USB_OTG_FS_DM
PA12.Signal=USB_OTG_FS_DP
PA13.Signal=SYS_JTMS-SWDIO
PA14.Signal=SYS_JTCK-SWCLK
PA15.GPIO_Label=PWM
PA15.Signal=S_TIM2_CH1_ETR
PA2.GPIO_Label=oled_RST
PA2.Signal=GPIO_Output
PA3.GPIO_Label=oled_DC
PA3.Signal=GPIO_Output
PA4.GPIO_Label=sd_CS
PA4.Signal=GPIO_Output
PA5.Signal=SPI1_SCK
PA6.Signal=SPI1_MISO
PA7.Signal=SPI1_MOSI
PA8.GPIO_Label=enc_CH1
PA8.Signal=S_TIM1_CH1
PA9.GPIO_Label=enc_CH2
PA9.Signal=S_TIM1_CH2
PB0.Signal=ADCx_IN8
PB1.Signal=ADCx_IN9
PB12.GPIO_Label=R1IN1
PB12.Signal=GPIO_Output
PB13.GPIO_Label=R1IN2
PB13.Signal=GPIO_Output
PB14.GPIO_Label=lipol_detection
PB14.Signal=GPXTI14
PB15.GPIO_Label=liion_detection
PB15.Signal=GPXTI15
PB3.GPIO_Label=bmp2_CS
PB3.Signal=GPIO_Output
PB4.GPIO_Label=PWM_discharge
PB4.Signal=S_TIM3_CH1
PB5.GPIO_Label=bmp1_CS
PB5.Signal=GPIO_Output
PB6.Signal=I2C1_SCL
PB7.GPIO_Label=PWM_charge
PB7.Signal=S_TIM4_CH2
PB8.GPIO_Label=bmp3_CS
PB8.Signal=GPIO_Output
PB9.Signal=I2C1_SDA
PC13-ANTI_TAMP.GPIO_Label=LED
PC13-ANTI_TAMP.Signal=GPIO_Output
