DLedzianowski/badanie-ogniw-projekt-inzynierski/software/STM32CubeIDE/badanie-ogniw/Core/Src/main.c

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
/* Includes ------------------------------------------------------------------*/
#include "main.h"
#include "adc.h"
#include "fatfs.h"
#include "i2c.h"
#include "spi.h"
#include "tim.h"
#include "usart.h"
#include "usb_otg.h"
#include "gpio.h"

/* USER CODE BEGIN Includes */
#include "st7735.h"
#include "fonts.h"
#include "testimg.h"
#include "BMPXX80.h"
#include "fatfs_sd.h"
#include "sensirion_common.h"
#include "sgp30.h"
#include "INA219.h"

/* USER CODE END Includes */


/* USER CODE BEGIN PV */
uint8_t isProgramStarted = 0;
uint8_t _interruptFlag = 0;

uint16_t adcPosition = 0;

struct sensors s = {0};
INA219_t myina219;

FATFS fs;
FIL fil;

/* USER CODE END PV */

void SystemClock_Config(void);
/* USER CODE BEGIN PFP */
void SDcardInit(char* folder_name);
void SDcardWriteData(struct sensors *s);
void SDcardClose(void);
void OLEDdisplay(struct sensors *s);
/* USER CODE END PFP */

/* USER CODE BEGIN 0 */
void SDcardInit(char* folder_name) {
    FRESULT res;
    uint8_t retry_count = 5;

    while (retry_count--) {
        res = f_mount(&fs, "", 1);
        if (res == FR_OK) {
            break;
        }
        printf("Error mounting filesystem! (%d). Retrying...\r\n", res);
     	  ST7735_WriteString(10, 140, "Error in file!", Font_7x10, ST7735_RED, ST7735_BLACK);
        HAL_Delay(RETRY_DELAY_MS);
    }

    retry_count = 5;
    while (retry_count--) {
        res = f_open(&fil, "test.txt", FA_OPEN_ALWAYS | FA_WRITE);
        if (res == FR_OK) {
            break;
        }
        printf("Error opening SDcard file! (%d). Retrying...\r\n", res);
     	  ST7735_WriteString(10, 140, "Error in file!", Font_7x10, ST7735_RED, ST7735_BLACK);
        HAL_Delay(RETRY_DELAY_MS);
    }

    res = f_lseek(&fil, f_size(&fil));
    if (res != FR_OK) {
        printf("Error seeking to end of file! (%d)\r\n", res);
        f_close(&fil);
        return;
    }

    f_puts("\n--- Nowy pomiar ---\n", &fil);
    f_puts("TVOC_ppb,CO2_eq_ppm,Ethanol_signal,H2_signal,Temperatura,Cisnienie,Napiecie_mV,Prad_mA,Moc_mW\n", &fil);

    f_sync(&fil);

}

void SDcardWriteData(struct sensors *s) {
	// ERROR SDcard -> OLED
	if (f_lseek(&fil, f_size(&fil)) != FR_OK) {
  	 printf("Error seeking in file!\r\n");
  	 ST7735_WriteString(10, 140, "Error in file!", Font_7x10, ST7735_RED, ST7735_BLACK);
  	 return;
	}

	char buffer[200];
	snprintf(buffer, sizeof(buffer), "%u,%u,%.2f,%.2f,%.2f,%ld,%u,%d,%u\n",
			s->tvoc_ppb, s->co2_eq_ppm, s->scaled_ethanol_signal/512.0f, s->scaled_h2_signal/512.0f, s->BMP280temperature, s->BMP280pressure,s->INA219_Voltage, s->INA219_Current, s->INA219_Power);

	if (f_puts(buffer, &fil) < 0) {
  	 printf("Error writing to file!\r\n");
	}

	if (f_sync(&fil) != FR_OK) {
		printf("Error syncing file!\r\n");
	}
	f_sync(&fil);
}

void SDcardClose(void) {
    if (f_close(&fil) != FR_OK) {
        printf("Error closing file!\r\n");
    }
}

void OLEDdisplay(struct sensors *s) {
    char buffer[100];
    int tempInt = (int)(s->BMP280temperature * 100);
    int tempFrac = tempInt % 100;

    // Temperatura
    snprintf(buffer, sizeof(buffer), "Temp: %d.%02d C", tempInt / 100, tempFrac);
    ST7735_WriteString(5,  5, buffer, Font_7x10, ST7735_WHITE, ST7735_BLACK);

    // Ciśnienie
    snprintf(buffer, sizeof(buffer), "Prs:  %ld Pa", s->BMP280pressure);
    ST7735_WriteString(5,  20, buffer, Font_7x10, ST7735_WHITE, ST7735_BLACK);

    // TVOC
    snprintf(buffer, sizeof(buffer), "TVOC: %4u ppb", s->tvoc_ppb);
    ST7735_WriteString(5,  35, buffer, Font_7x10, ST7735_WHITE, ST7735_BLACK);

    // CO2eq
    snprintf(buffer, sizeof(buffer), "CO2:  %4u ppm", s->co2_eq_ppm);
    ST7735_WriteString(5,  50, buffer, Font_7x10, ST7735_WHITE, ST7735_BLACK);

    // Etanol/512.0
    float ethanol = s->scaled_ethanol_signal / 512.0f;
    snprintf(buffer, sizeof(buffer), "EtOH: %.2f", ethanol);
    ST7735_WriteString(5,  65, buffer, Font_7x10, ST7735_WHITE, ST7735_BLACK);

    // H2/512.0
    float h2 = s->scaled_h2_signal / 512.0f;
    snprintf(buffer, sizeof(buffer), "H2:   %.2f", h2);
    ST7735_WriteString(5,  80, buffer, Font_7x10, ST7735_WHITE, ST7735_BLACK);

    // INA219_Current
    snprintf(buffer, sizeof(buffer), "Current:  %4d mA", s->INA219_Current);
    ST7735_WriteString(5,  95, buffer, Font_7x10, ST7735_WHITE, ST7735_BLACK);

    // INA219_Voltage
    snprintf(buffer, sizeof(buffer), "Voltage:  %4u mV", s->INA219_Voltage);
    ST7735_WriteString(5,  110, buffer, Font_7x10, ST7735_WHITE, ST7735_BLACK);

    // INA219_Power
    snprintf(buffer, sizeof(buffer), "Power:  %4u mW", s->INA219_Power);
    ST7735_WriteString(5,  125, buffer, Font_7x10, ST7735_WHITE, ST7735_BLACK);

}

/* USER CODE END 0 */

/**
  * @brief  The application entry point.
  * @retval int
  */
int main(void)
{

  /* MCU Configuration--------------------------------------------------------*/

  /* Reset of all peripherals, Initializes the Flash interface and the Systick. */
  HAL_Init();

  /* Configure the system clock */
  SystemClock_Config();

  /* Initialize all configured peripherals */
  MX_GPIO_Init();
  MX_I2C1_Init();
  MX_USART3_UART_Init();
  MX_USB_OTG_FS_PCD_Init();
  MX_SPI1_Init();
  MX_FATFS_Init();
  MX_TIM7_Init();
  MX_ADC1_Init();
  MX_TIM3_Init();
  /* USER CODE BEGIN 2 */
  HAL_TIM_Base_Start_IT(&htim7);
  HAL_TIM_PWM_Start(&htim3, TIM_CHANNEL_1);
  // OLED
  ST7735_Init();
  ST7735_FillScreen(ST7735_BLACK);

  // BMP
  BMP280_Init(&hspi1, BMP280_TEMPERATURE_16BIT, BMP280_STANDARD, BMP280_FORCEDMODE);
  // SGP
	if (sgp_probe() != STATUS_OK) {
		printf("SGP sensor error\r\n");
	}
	// INA
	INA219_Init(&myina219, &hi2c1, INA219_ADDRESS);
	//INA219_setCalibration_32V_2A(&myina219);

	// SD
	SDcardInit("test.txt");
	isProgramStarted = 1;
  /* USER CODE END 2 */

  /* Infinite loop */
  /* USER CODE BEGIN WHILE */
  while (1)
  {
    /* USER CODE END WHILE */

    /* USER CODE BEGIN 3 */

  	// stele probkowanie
  	if (_interruptFlag == 1){

    	// ADC
    	HAL_ADC_Start(&hadc1);
    	HAL_ADC_PollForConversion(&hadc1, 1);
    	adcPosition = HAL_ADC_GetValue(&hadc1) ;
    	printf("ADC: %.2f%%\r\n", (adcPosition / 4095.0f)*100);

    	__HAL_TIM_SET_COMPARE(&htim3, TIM_CHANNEL_1, (adcPosition / 4095.0f)*1000);


  		// BMP
			BMP280_ReadTemperatureAndPressure(&s.BMP280temperature, &s.BMP280pressure);

			// SGP
			sgp_measure_iaq_blocking_read(&s.tvoc_ppb, &s.co2_eq_ppm);
			sgp_measure_signals_blocking_read(&s.scaled_ethanol_signal, &s.scaled_h2_signal);
			//sgp_set_absolute_humidity()

			// INA219
			s.INA219_Current = INA219_ReadCurrent_raw(&myina219);
			s.INA219_Voltage = INA219_ReadBusVoltage(&myina219);
			s.INA219_Power = INA219_ReadPower(&myina219);


			// SD
			SDcardWriteData(&s);

			// OLED
			OLEDdisplay(&s);

			printf("{%u,%u,%.2f,%.2f,%.2f,%ld,%u,%d,%u}\r\n",
					s.tvoc_ppb, s.co2_eq_ppm, s.scaled_ethanol_signal/512.0f, s.scaled_h2_signal/512.0f, s.BMP280temperature, s.BMP280pressure, s.INA219_Voltage, s.INA219_Current, s.INA219_Power);

			_interruptFlag = 0;
  	}
  }
  /* USER CODE END 3 */
}

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
/* USER CODE BEGIN 4 */

void HAL_TIM_PeriodElapsedCallback(TIM_HandleTypeDef *htim){
  if (htim == &htim7 && isProgramStarted == 1){
  	if (_interruptFlag == 1){
  		printf("Flaga _interruptFlag jest juz 1");
  	}
  	_interruptFlag = 1;
  }
}

/* USER CODE END 4 */
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
