DLedzianowski/badanie-ogniw-projekt-inzynierski/software/STM32CubeIDE/badanie-ogniw-blackpill/Core/Inc/main.h

#define BME_SENSOR_COUNT 3
#define BATERYS_NUM 3
#define STATUS_NUM 3
#define AUTO_MODE_NUM 2
#define SCREENS_MENU_VISIBLE_ITEMS 5  // number of visible opcions in menu
#define SCREENS_MENU_NUM 7  // numbers of all menu elements
#define RETRY_DELAY_MS 1000
#define SCREENS_SENSORS_NUM 2  // number of screens with sensors data
#define ENABLE_DEBUG   1
#define ENABLE_DATA    1
#define LED_Pin GPIO_PIN_13
#define LED_GPIO_Port GPIOC
#define oled_CS_Pin GPIO_PIN_1
#define oled_CS_GPIO_Port GPIOA
#define oled_RST_Pin GPIO_PIN_2
#define oled_RST_GPIO_Port GPIOA
#define oled_DC_Pin GPIO_PIN_3
#define oled_DC_GPIO_Port GPIOA
#define sd_CS_Pin GPIO_PIN_4
#define sd_CS_GPIO_Port GPIOA
#define R1IN1_Pin GPIO_PIN_12
#define R1IN1_GPIO_Port GPIOB
#define R1IN2_Pin GPIO_PIN_13
#define R1IN2_GPIO_Port GPIOB
#define lipol_detection_Pin GPIO_PIN_14
#define lipol_detection_GPIO_Port GPIOB
#define lipol_detection_EXTI_IRQn EXTI15_10_IRQn
#define liion_detection_Pin GPIO_PIN_15
#define liion_detection_GPIO_Port GPIOB
#define liion_detection_EXTI_IRQn EXTI15_10_IRQn
#define enc_CH1_Pin GPIO_PIN_8
#define enc_CH1_GPIO_Port GPIOA
#define enc_CH2_Pin GPIO_PIN_9
#define enc_CH2_GPIO_Port GPIOA
#define enc_KEY_Pin GPIO_PIN_10
#define enc_KEY_GPIO_Port GPIOA
#define enc_KEY_EXTI_IRQn EXTI15_10_IRQn
#define PWM_Pin GPIO_PIN_15
#define PWM_GPIO_Port GPIOA
#define bmp2_CS_Pin GPIO_PIN_3
#define bmp2_CS_GPIO_Port GPIOB
#define PWM_discharge_Pin GPIO_PIN_4
#define PWM_discharge_GPIO_Port GPIOB
#define bmp1_CS_Pin GPIO_PIN_5
#define bmp1_CS_GPIO_Port GPIOB
#define PWM_charge_Pin GPIO_PIN_7
#define PWM_charge_GPIO_Port GPIOB
#define bmp3_CS_Pin GPIO_PIN_8
#define bmp3_CS_GPIO_Port GPIOB
