DLedzianowski/badanie-ogniw-projekt-inzynierski/software/STM32CubeIDE/badanie-ogniw/Core/Src/BMXX80.c

/*
 * BMXX80.c
 *
 *	The MIT License.
 *	Based on Adafuit libraries.
 *  Created on: 10.08.2018
 *      Author: Mateusz Salamon
 *      www.msalamon.pl
 *
 */
#define BMP_CS_GPIO_Port GPIOE
#define BMP_CS_Pin GPIO_PIN_9


#include "main.h"
#include "stm32f7xx_hal.h"
//#include "gpio.h"
#include "BMPXX80.h"

#include "math.h"

#ifdef BMP180
#include "delays.h"
#endif
#ifdef BME280
#include "delays.h"
#endif
//
//	 Private variables
//
#if(BMP_I2C == 1)
I2C_HandleTypeDef *i2c_h;
#endif
#if(BMP_SPI == 1)
SPI_HandleTypeDef *spi_h;
#endif

#ifdef BMP180
uint8_t oversampling;
int16_t ac1, ac2, ac3, b1, b2, mb, mc, md;
uint16_t ac4, ac5, ac6;
#endif
#ifdef BMP280
uint8_t _temperature_res, _pressure_oversampling,  _mode;
int16_t t2, t3, p2, p3, p4, p5, p6, p7, p8, p9;
uint16_t t1, p1;
int32_t t_fine;
#endif
#ifdef BME280
uint8_t _temperature_res, _pressure_oversampling, _huminidity_oversampling,  _mode, h1, h3;
int8_t h6;
int16_t t2, t3, p2, p3, p4, p5, p6, p7, p8, p9, h2, h4, h5;
uint16_t t1, p1;
int32_t t_fine;
#endif
//
//	Functions
//
#ifdef BMP180
uint8_t BMP180_Read8(uint8_t addr)
{
  uint8_t tmp=7;

  HAL_I2C_Mem_Read(i2c_h, BMP180_I2CADDR, addr, 1, &tmp, 1, 10);

  return tmp;
}
#endif
#ifdef BMP280
uint8_t BMP280_Read8(uint8_t addr)
{
#if(BMP_I2C == 1)
	uint8_t tmp = 0;
  HAL_I2C_Mem_Read(i2c_h, BMP280_I2CADDR, addr, 1, &tmp, 1, 10);
  return tmp;
#endif
#if(BMP_SPI == 1)
    uint8_t tmp[2];
	tmp[0] = addr;
	tmp[0] |= (1<<7);
	HAL_GPIO_WritePin(BMP_CS_GPIO_Port, BMP_CS_Pin, GPIO_PIN_RESET);
	HAL_SPI_TransmitReceive(spi_h, tmp, tmp, 2, 10);
	HAL_GPIO_WritePin(BMP_CS_GPIO_Port, BMP_CS_Pin, GPIO_PIN_SET);
	return tmp[1];
#endif
}
#endif
#ifdef BME280
uint8_t BME280_Read8(uint8_t addr)
{
#if(BMP_I2C == 1)
	uint8_t tmp = 0;
	HAL_I2C_Mem_Read(i2c_h, BME280_I2CADDR, addr, 1, &tmp, 1, 10);
	return tmp;
#endif
  uint8_t tmp[2];
	tmp[0] = addr;
	tmp[0] |= (1<<7);
	HAL_GPIO_WritePin(BMP_CS_GPIO_Port, BMP_CS_Pin, GPIO_PIN_RESET);
	HAL_SPI_TransmitReceive(spi_h, tmp, tmp, 2, 10);
	HAL_GPIO_WritePin(BMP_CS_GPIO_Port, BMP_CS_Pin, GPIO_PIN_SET);
	return tmp[1];
}
#endif

#ifdef BMP180
uint16_t BMP180_Read16(uint8_t addr)
{

	uint8_t tmp[2];

	HAL_I2C_Mem_Read(i2c_h, BMP180_I2CADDR, addr, 1, tmp, 2, 10);

	return ((tmp[0] << 8) | tmp[1]);
}
#endif
#ifdef BMP280
uint16_t BMP280_Read16(uint8_t addr)
{
#if(BMP_I2C == 1)
	uint8_t tmp[2];
	HAL_I2C_Mem_Read(i2c_h, BMP280_I2CADDR, addr, 1, tmp, 2, 10);
	return ((tmp[0] << 8) | tmp[1]);
#endif
#if(BMP_SPI == 1)
	uint8_t tmp[3];
	tmp[0] = addr;
	tmp[0] |= (1<<7);
	HAL_GPIO_WritePin(BMP_CS_GPIO_Port, BMP_CS_Pin, GPIO_PIN_RESET);
	HAL_SPI_TransmitReceive(spi_h, tmp, tmp, 3, 10);
	HAL_GPIO_WritePin(BMP_CS_GPIO_Port, BMP_CS_Pin, GPIO_PIN_SET);
	return ((tmp[1] << 8) | tmp[2]);
#endif
}

uint16_t BMP280_Read16LE(uint8_t addr)
{
	uint16_t tmp;

	tmp = BMP280_Read16(addr);
	return (tmp >> 8) | (tmp << 8);
}
#endif
#ifdef BME280
uint16_t BME280_Read16(uint8_t addr)
{
#if(BMP_I2C == 1)
	uint8_t tmp[2];
	HAL_I2C_Mem_Read(i2c_h, BMP280_I2CADDR, addr, 1, tmp, 2, 10);
	return ((tmp[0] << 8) | tmp[1]);
#endif
#if(BMP_SPI == 1)
	uint8_t tmp[3];
	tmp[0] = addr;
	tmp[0] |= (1<<7);
	HAL_GPIO_WritePin(BMP_CS_GPIO_Port, BMP_CS_Pin, GPIO_PIN_RESET);
	HAL_SPI_TransmitReceive(spi_h, tmp, tmp, 3, 10);
	HAL_GPIO_WritePin(BMP_CS_GPIO_Port, BMP_CS_Pin, GPIO_PIN_SET);
	return ((tmp[1] << 8) | tmp[2]);
#endif
}

uint16_t BME280_Read16LE(uint8_t addr)
{
	uint16_t tmp;

	tmp = BME280_Read16(addr);
	return (tmp >> 8) | (tmp << 8);
}
#endif

#ifdef BMP180
void BMP180_Write8(uint8_t address, uint8_t data)
{
	HAL_I2C_Mem_Write(i2c_h, BMP180_I2CADDR, address, 1, &data, 1, 10);
}
#endif
#ifdef BMP280
void BMP280_Write8(uint8_t address, uint8_t data)
{
#if(BMP_I2C == 1)
	HAL_I2C_Mem_Write(i2c_h, BMP280_I2CADDR, address, 1, &data, 1, 10);
#endif
#if(BMP_SPI == 1)
	uint8_t tmp[2];
	tmp[0] = address;
	tmp[0] &= ~(1<<7);
	tmp[1] = data;
	HAL_GPIO_WritePin(BMP_CS_GPIO_Port, BMP_CS_Pin, GPIO_PIN_RESET);
	HAL_SPI_TransmitReceive(spi_h, tmp, tmp, 2, 10);
	HAL_GPIO_WritePin(BMP_CS_GPIO_Port, BMP_CS_Pin, GPIO_PIN_SET);
#endif
}

uint32_t BMP280_Read24(uint8_t addr)
{
#if(BMP_I2C == 1)
	uint8_t tmp[3];
	HAL_I2C_Mem_Read(i2c_h, BMP280_I2CADDR, addr, 1, tmp, 3, 10);
	return ((tmp[0] << 16) | tmp[1] << 8 | tmp[2]);
#endif
#if(BMP_SPI == 1)
	uint8_t tmp[4];
	tmp[0] = addr;
	tmp[0] |= (1<<7);
	HAL_GPIO_WritePin(BMP_CS_GPIO_Port, BMP_CS_Pin, GPIO_PIN_RESET);
	HAL_SPI_TransmitReceive(spi_h, tmp, tmp, 3, 10);
	HAL_GPIO_WritePin(BMP_CS_GPIO_Port, BMP_CS_Pin, GPIO_PIN_SET);
	return ((tmp[1] << 16) | tmp[2] << 8 | tmp[3]);
#endif
}
#endif
#ifdef BME280
void BME280_Write8(uint8_t address, uint8_t data)
{
#if(BMP_I2C == 1)
	HAL_I2C_Mem_Write(i2c_h, BME280_I2CADDR, address, 1, &data, 1, 10);
#endif
#if(BMP_SPI == 1)
	uint8_t tmp[2];
	tmp[0] = address;
	tmp[0] &= ~(1<<7);
	tmp[1] = data;
	HAL_GPIO_WritePin(BMP_CS_GPIO_Port, BMP_CS_Pin, GPIO_PIN_RESET);
	HAL_SPI_TransmitReceive(spi_h, tmp, tmp, 2, 10);
	HAL_GPIO_WritePin(BMP_CS_GPIO_Port, BMP_CS_Pin, GPIO_PIN_SET);
#endif
}

uint32_t BME280_Read24(uint8_t addr)
{
#if(BMP_I2C == 1)
	uint8_t tmp[3];
	HAL_I2C_Mem_Read(i2c_h, BMP280_I2CADDR, addr, 1, tmp, 3, 10);
	return ((tmp[0] << 16) | tmp[1] << 8 | tmp[2]);
#endif
#if(BMP_SPI == 1)
	uint8_t tmp[4];
	tmp[0] = addr;
	tmp[0] |= (1<<7);
	HAL_GPIO_WritePin(BMP_CS_GPIO_Port, BMP_CS_Pin, GPIO_PIN_RESET);
	HAL_SPI_TransmitReceive(spi_h, tmp, tmp, 3, 10);
	HAL_GPIO_WritePin(BMP_CS_GPIO_Port, BMP_CS_Pin, GPIO_PIN_SET);
	return ((tmp[1] << 16) | tmp[2] << 8 | tmp[3]);
#endif
}
#endif

#ifdef BMP180
uint16_t BMP180_readRawTemperature()
{
	  BMP180_Write8(BMP180_CONTROL, BMP180_READTEMPCMD);
	  while((BMP180_Read8(BMP180_CONTROL) & BMP180_SCO));
//	  Delay_us(5000);
	  return BMP180_Read16(BMP180_TEMPDATA);
}
#endif

#ifdef BMP180
int32_t BMP180_computeB5(int32_t UT)
{
	  int32_t X1 = (UT - (int32_t)ac6) * ((int32_t)ac5) >> 15;
	  int32_t X2 = ((int32_t)mc << 11) / (X1+(int32_t)md);
	  return X1 + X2;
}
#endif

#ifdef BMP180
int32_t BMP180_readRawPressure()
{
	  uint32_t raw;

	  BMP180_Write8(BMP180_CONTROL, BMP180_READPRESSURECMD + (oversampling << 6));

	  if (oversampling == BMP180_ULTRALOWPOWER)
		while((BMP180_Read8(BMP180_CONTROL) & BMP180_SCO));
//		Delay_us(5000);
	  else if (oversampling == BMP180_STANDARD)
		while((BMP180_Read8(BMP180_CONTROL) & BMP180_SCO));
//		Delay_us(8000);
	  else if (oversampling == BMP180_HIGHRES)
		while((BMP180_Read8(BMP180_CONTROL) & BMP180_SCO));
//		Delay_us(14000);
	  else
		while((BMP180_Read8(BMP180_CONTROL) & BMP180_SCO));
//		Delay_us(26000);

	  raw = BMP180_Read16(BMP180_PRESSUREDATA);

	  raw <<= 8;
	  raw |= BMP180_Read8(BMP180_PRESSUREDATA+2);
	  raw >>= (8 - oversampling);

	  return raw;
}
#endif

#ifdef BMP180
void BMP180_Init(I2C_HandleTypeDef *i2c_handler, uint8_t mode)
{
	i2c_h = i2c_handler;

	if (mode > BMP180_ULTRAHIGHRES)
	    mode = BMP180_ULTRAHIGHRES;
	  oversampling = mode;

	  while(BMP180_Read8(BMP180_CHIPID) != 0x55);

	  /* read calibration data */
	  ac1 = BMP180_Read16(BMP180_CAL_AC1);
	  ac2 = BMP180_Read16(BMP180_CAL_AC2);
	  ac3 = BMP180_Read16(BMP180_CAL_AC3);
	  ac4 = BMP180_Read16(BMP180_CAL_AC4);
	  ac5 = BMP180_Read16(BMP180_CAL_AC5);
	  ac6 = BMP180_Read16(BMP180_CAL_AC6);

	  b1 = BMP180_Read16(BMP180_CAL_B1);
	  b2 = BMP180_Read16(BMP180_CAL_B2);

	  mb = BMP180_Read16(BMP180_CAL_MB);
	  mc = BMP180_Read16(BMP180_CAL_MC);
	  md = BMP180_Read16(BMP180_CAL_MD);
}
#endif
#ifdef BMP280
void BMP280_SetConfig(uint8_t standby_time, uint8_t filter)
{
	BMP280_Write8(BMP280_CONFIG, (((standby_time & 0x7) << 5) | ((filter & 0x7) << 2)) & 0xFC);
}
#if(BMP_I2C == 1)
void BMP280_Init(I2C_HandleTypeDef *i2c_handler, uint8_t temperature_resolution, uint8_t pressure_oversampling, uint8_t mode)
{
	i2c_h = i2c_handler;
#endif
#if(BMP_SPI == 1)
void BMP280_Init(SPI_HandleTypeDef *spi_handler, uint8_t temperature_resolution, uint8_t pressure_oversampling, uint8_t mode)
{
	spi_h = spi_handler;
	HAL_GPIO_WritePin(BMP_CS_GPIO_Port, BMP_CS_Pin, GPIO_PIN_RESET);
	HAL_Delay(5);
	HAL_GPIO_WritePin(BMP_CS_GPIO_Port, BMP_CS_Pin, GPIO_PIN_SET);
#endif
	if (mode > BMP280_NORMALMODE)
	    mode = BMP280_NORMALMODE;
	_mode = mode;
	if(mode == BMP280_FORCEDMODE)
		mode = BMP280_SLEEPMODE;



	if (temperature_resolution > BMP280_TEMPERATURE_20BIT)
		temperature_resolution = BMP280_TEMPERATURE_20BIT;
	_temperature_res = temperature_resolution;

	if (pressure_oversampling > BMP280_ULTRAHIGHRES)
		pressure_oversampling = BMP280_ULTRAHIGHRES;
	_pressure_oversampling = pressure_oversampling;

	while(BMP280_Read8(BMP280_CHIPID) != 0x58);

	/* read calibration data */
	t1 = BMP280_Read16LE(BMP280_DIG_T1);
	t2 = BMP280_Read16LE(BMP280_DIG_T2);
	t3 = BMP280_Read16LE(BMP280_DIG_T3);

	p1 = BMP280_Read16LE(BMP280_DIG_P1);
	p2 = BMP280_Read16LE(BMP280_DIG_P2);
	p3 = BMP280_Read16LE(BMP280_DIG_P3);
	p4 = BMP280_Read16LE(BMP280_DIG_P4);
	p5 = BMP280_Read16LE(BMP280_DIG_P5);
	p6 = BMP280_Read16LE(BMP280_DIG_P6);
	p7 = BMP280_Read16LE(BMP280_DIG_P7);
	p8 = BMP280_Read16LE(BMP280_DIG_P8);
	p9 = BMP280_Read16LE(BMP280_DIG_P9);

	BMP280_Write8(BMP280_CONTROL, ((temperature_resolution<<5) | (pressure_oversampling<<2) | mode));
}
#endif
#ifdef BME280
uint8_t BME280_IsReadingCalibration(void)
{
	uint8_t Status = BME280_Read8(BME280_STATUS);

	return ((Status & 1) != 0);
}

void BME280_SetConfig(uint8_t standby_time, uint8_t filter)
{
	BME280_Write8(BME280_CONFIG, (uint8_t)(((standby_time & 0x7) << 5) | ((filter & 0x7) << 2)) & 0xFC);
}

#if(BMP_I2C == 1)
void BME280_Init(I2C_HandleTypeDef *i2c_handler, uint8_t temperature_resolution, uint8_t pressure_oversampling, uint8_t huminidity_oversampling, uint8_t mode)
{
	i2c_h = i2c_handler;
#endif
#if(BMP_SPI == 1)
void BME280_Init(SPI_HandleTypeDef *spi_handler, uint8_t temperature_resolution, uint8_t pressure_oversampling, uint8_t huminidity_oversampling, uint8_t mode)
{
	spi_h = spi_handler;
	HAL_GPIO_WritePin(BMP_CS_GPIO_Port, BMP_CS_Pin, GPIO_PIN_RESET);
	HAL_Delay(5);
	HAL_GPIO_WritePin(BMP_CS_GPIO_Port, BMP_CS_Pin, GPIO_PIN_SET);
#endif
	uint8_t HumReg, i;

	if (mode > BME280_NORMALMODE)
	    mode = BME280_NORMALMODE;
	_mode = mode;
	if(mode == BME280_FORCEDMODE)
		mode = BME280_SLEEPMODE;

	if (temperature_resolution > BME280_TEMPERATURE_20BIT)
		temperature_resolution = BME280_TEMPERATURE_20BIT;
	_temperature_res = temperature_resolution;

	if (pressure_oversampling > BME280_PRESSURE_ULTRAHIGHRES)
		pressure_oversampling = BME280_PRESSURE_ULTRAHIGHRES;
	_pressure_oversampling = pressure_oversampling;

	if (huminidity_oversampling > BME280_HUMINIDITY_ULTRAHIGH)
		huminidity_oversampling = BME280_HUMINIDITY_ULTRAHIGH;
	_huminidity_oversampling = huminidity_oversampling;

	while(BME280_Read8(BME280_CHIPID) != 0x60);

	BME280_Write8(BME280_SOFTRESET, 0xB6);

	for(i = 0; i<30; i++)
		Delay_us(1000); // Wait  300 msfor wake up

	while(BME280_IsReadingCalibration())
		for(i = 0; i<10; i++)
			Delay_us(1000);

	/* read calibration data */
	t1 = BME280_Read16LE(BME280_DIG_T1);
	t2 = BME280_Read16LE(BME280_DIG_T2);
	t3 = BME280_Read16LE(BME280_DIG_T3);

	p1 = BME280_Read16LE(BME280_DIG_P1);
	p2 = BME280_Read16LE(BME280_DIG_P2);
	p3 = BME280_Read16LE(BME280_DIG_P3);
	p4 = BME280_Read16LE(BME280_DIG_P4);
	p5 = BME280_Read16LE(BME280_DIG_P5);
	p6 = BME280_Read16LE(BME280_DIG_P6);
	p7 = BME280_Read16LE(BME280_DIG_P7);
	p8 = BME280_Read16LE(BME280_DIG_P8);
	p9 = BME280_Read16LE(BME280_DIG_P9);

	h1 = BME280_Read8(BME280_DIG_H1);
	h2 = BME280_Read16LE(BME280_DIG_H2);
	h3 = BME280_Read8(BME280_DIG_H3);
	h4 = ((BME280_Read8(BME280_DIG_H4) << 4 ) | (BME280_Read8(BME280_DIG_H4+1) & 0xF));
	h5 = ((BME280_Read8(BME280_DIG_H5+1) << 4) | (BME280_Read8(BME280_DIG_H5) >> 4));
	h6 = (int8_t)BME280_Read8(BME280_DIG_H6);

	HumReg = BME280_Read8(BME280_HUM_CONTROL);
	HumReg &= 0xF8;
	HumReg |= _huminidity_oversampling;
	BME280_Write8(BME280_HUM_CONTROL, HumReg);
	HumReg = BME280_Read8(BME280_HUM_CONTROL);
	BME280_Write8(BME280_CONTROL, ((temperature_resolution<<5) | (pressure_oversampling<<2) | mode));

	if(mode == BME280_NORMALMODE)
	{
		BME280_SetConfig(BME280_STANDBY_MS_0_5, BME280_FILTER_OFF);
	}
}
#endif

#ifdef BMP180
float BMP180_ReadTemperature(void)
{
	  int32_t UT, B5;     // following ds convention
	  float temp;

	  UT = BMP180_readRawTemperature();

	  B5 = BMP180_computeB5(UT);
	  temp = (B5+8) >> 4;
	  temp /= 10;

	  return temp;
}
#endif
#ifdef BMP280
float BMP280_ReadTemperature(void)
{
  int32_t var1, var2;

  if(_mode == BMP280_FORCEDMODE)
  {
	  uint8_t mode;
	  uint8_t ctrl = BMP280_Read8(BMP280_CONTROL);
	  ctrl &= ~(0x03);
	  ctrl |= BMP280_FORCEDMODE;
	  BMP280_Write8(BMP280_CONTROL, ctrl);

	  mode = BMP280_Read8(BMP280_CONTROL); 	// Read written mode
	  mode &= 0x03;							// Do not work without it...

	  if(mode == BMP280_FORCEDMODE)
	  {
		  while(1) // Wait for end of conversion
		  {
			  mode = BMP280_Read8(BMP280_CONTROL);
			  mode &= 0x03;
			  if(mode == BMP280_SLEEPMODE)
				  break;
		  }

		  int32_t adc_T = BMP280_Read24(BMP280_TEMPDATA);
		  adc_T >>= 4;

		  var1  = ((((adc_T>>3) - ((int32_t)t1 <<1))) *
				  ((int32_t)t2)) >> 11;

		  var2  = (((((adc_T>>4) - ((int32_t)t1)) *
				  ((adc_T>>4) - ((int32_t)t1))) >> 12) *
				  ((int32_t)t3)) >> 14;

		  t_fine = var1 + var2;

		  float T  = (t_fine * 5 + 128) >> 8;
		  return T/100;
	  }
  }

  return -99;
}
#endif
#ifdef BME280
float BME280_ReadTemperature(void)
{
  int32_t var1, var2;

  if(_mode == BME280_FORCEDMODE)
  {
	  uint8_t mode;
	  uint8_t ctrl = BME280_Read8(BME280_CONTROL);
	  ctrl &= ~(0x03);
	  ctrl |= BME280_FORCEDMODE;
	  BME280_Write8(BME280_CONTROL, ctrl);

	  mode = BME280_Read8(BME280_CONTROL); 	// Read written mode
	  mode &= 0x03;							// Do not work without it...

	  if(mode == BME280_FORCEDMODE)
	  {
		  while(1) // Wait for end of conversion
		  {
			  mode = BME280_Read8(BME280_CONTROL);
			  mode &= 0x03;
			  if(mode == BME280_SLEEPMODE)
				  break;
		  }
	  }
  }

  int32_t adc_T = BME280_Read24(BME280_TEMPDATA);
  if (adc_T == 0x800000)
	  return -99;

  adc_T >>= 4;

  var1  = ((((adc_T>>3) - ((int32_t)t1 <<1))) *
		  ((int32_t)t2)) >> 11;

  var2  = (((((adc_T>>4) - ((int32_t)t1)) *
		  ((adc_T>>4) - ((int32_t)t1))) >> 12) *
		  ((int32_t)t3)) >> 14;

  t_fine = var1 + var2;

  float T  = (t_fine * 5 + 128) >> 8;
  return T/100;

  return -99;
}
#endif

#ifdef BMP180
int32_t BMP180_ReadPressure(void)
{
	  int32_t UT, UP, B3, B5, B6, X1, X2, X3, p;
	  uint32_t B4, B7;

	  UT = BMP180_readRawTemperature();
	  UP = BMP180_readRawPressure();

	  B5 = BMP180_computeB5(UT);

	  // do pressure calcs
	  B6 = B5 - 4000;
	  X1 = ((int32_t)b2 * ( (B6 * B6)>>12 )) >> 11;
	  X2 = ((int32_t)ac2 * B6) >> 11;
	  X3 = X1 + X2;
	  B3 = ((((int32_t)ac1*4 + X3) << oversampling) + 2) / 4;



	  X1 = ((int32_t)ac3 * B6) >> 13;
	  X2 = ((int32_t)b1 * ((B6 * B6) >> 12)) >> 16;
	  X3 = ((X1 + X2) + 2) >> 2;
	  B4 = ((uint32_t)ac4 * (uint32_t)(X3 + 32768)) >> 15;
	  B7 = ((uint32_t)UP - B3) * (uint32_t)( 50000UL >> oversampling );


	  if (B7 < 0x80000000) {
	    p = (B7 * 2) / B4;
	  } else {
	    p = (B7 / B4) * 2;
	  }
	  X1 = (p >> 8) * (p >> 8);
	  X1 = (X1 * 3038) >> 16;
	  X2 = (-7357 * p) >> 16;


	  p = p + ((X1 + X2 + (int32_t)3791)>>4);

	  return p;
}
#endif
#ifdef BMP280
int32_t BMP280_ReadPressure(void)
{
	  int64_t var1, var2, p;

	  // Must be done first to get the t_fine variable set up
	  BMP280_ReadTemperature();

	  int32_t adc_P = BMP280_Read24(BMP280_PRESSUREDATA);
	  adc_P >>= 4;

	  var1 = ((int64_t)t_fine) - 128000;
	  var2 = var1 * var1 * (int64_t)p6;
	  var2 = var2 + ((var1*(int64_t)p5)<<17);
	  var2 = var2 + (((int64_t)p4)<<35);
	  var1 = ((var1 * var1 * (int64_t)p3)>>8) +
	    ((var1 * (int64_t)p2)<<12);
	  var1 = (((((int64_t)1)<<47)+var1))*((int64_t)p1)>>33;

	  if (var1 == 0) {
	    return 0;  // avoid exception caused by division by zero
	  }
	  p = 1048576 - adc_P;
	  p = (((p<<31) - var2)*3125) / var1;
	  var1 = (((int64_t)p9) * (p>>13) * (p>>13)) >> 25;
	  var2 = (((int64_t)p8) * p) >> 19;

	  p = ((p + var1 + var2) >> 8) + (((int64_t)p7)<<4);
	  return (int32_t)p/256;
}
#endif
#ifdef BME280
int32_t BME280_ReadPressure(void)
{
	int64_t var1, var2, p;

	// Must be done first to get the t_fine variable set up
	BME280_ReadTemperature();

	int32_t adc_P = BME280_Read24(BME280_PRESSUREDATA);
	adc_P >>= 4;

	var1 = ((int64_t)t_fine) - 128000;
	var2 = var1 * var1 * (int64_t)p6;
	var2 = var2 + ((var1*(int64_t)p5)<<17);
	var2 = var2 + (((int64_t)p4)<<35);
	var1 = ((var1 * var1 * (int64_t)p3)>>8) +
			((var1 * (int64_t)p2)<<12);
	var1 = (((((int64_t)1)<<47)+var1))*((int64_t)p1)>>33;

	if (var1 == 0) {
		return 0;  // avoid exception caused by division by zero
	}
	p = 1048576 - adc_P;
	p = (((p<<31) - var2)*3125) / var1;
	var1 = (((int64_t)p9) * (p>>13) * (p>>13)) >> 25;
	var2 = (((int64_t)p8) * p) >> 19;

	p = ((p + var1 + var2) >> 8) + (((int64_t)p7)<<4);
	return (int32_t)p/256;
}

float BME280_ReadHuminidity(void)
{
	// Must be done first to get the t_fine variable set up
	BME280_ReadTemperature();

	int32_t adc_H = BME280_Read16(BME280_HUMIDDATA);
	if (adc_H == 0x8000) // value in case humidity measurement was disabled
	   return -99; //error
	int32_t v_x1_u32r;

	v_x1_u32r = (t_fine - ((int32_t)76800));

	  v_x1_u32r = (((((adc_H << 14) - (((int32_t)h4) << 20) -
					  (((int32_t)h5) * v_x1_u32r)) + ((int32_t)16384)) >> 15) *
				   (((((((v_x1_u32r * ((int32_t)h6)) >> 10) *
						(((v_x1_u32r * ((int32_t)h3)) >> 11) + ((int32_t)32768))) >> 10) +
					  ((int32_t)2097152)) * ((int32_t)h2) + 8192) >> 14));

	  v_x1_u32r = (v_x1_u32r - (((((v_x1_u32r >> 15) * (v_x1_u32r >> 15)) >> 7) *
								 ((int32_t)h1)) >> 4));

	  v_x1_u32r = (v_x1_u32r < 0) ? 0 : v_x1_u32r;
	  v_x1_u32r = (v_x1_u32r > 419430400) ? 419430400 : v_x1_u32r;
	  float h = (v_x1_u32r>>12);
	  return  h / 1024.0;
}
#endif

#ifdef BMP180
float BMP180_PressureToAltitude(float sea_level, float atmospheric)
{
	return 44330.0 * (1.0 - pow(atmospheric / sea_level, 0.1903));
}
#endif

#ifdef BMP180
float BMP180_SeaLevelForAltitude(float altitude, float atmospheric)
{
	return atmospheric / pow(1.0 - (altitude/44330.0), 5.255);
}
#endif

#ifdef BMP280
uint8_t BMP280_ReadTemperatureAndPressure(float *temperature, int32_t *pressure)
{
	  int64_t var1, var2, p;

	  // Must be done first to get the t_fine variable set up
	  *temperature = BMP280_ReadTemperature();

	  if(*temperature == -99)
		  return -1;

	  int32_t adc_P = BMP280_Read24(BMP280_PRESSUREDATA);
	  adc_P >>= 4;

	  var1 = ((int64_t)t_fine) - 128000;
	  var2 = var1 * var1 * (int64_t)p6;
	  var2 = var2 + ((var1*(int64_t)p5)<<17);
	  var2 = var2 + (((int64_t)p4)<<35);
	  var1 = ((var1 * var1 * (int64_t)p3)>>8) +
	    ((var1 * (int64_t)p2)<<12);
	  var1 = (((((int64_t)1)<<47)+var1))*((int64_t)p1)>>33;

	  if (var1 == 0) {
	    return 0;  // avoid exception caused by division by zero
	  }
	  p = 1048576 - adc_P;
	  p = (((p<<31) - var2)*3125) / var1;
	  var1 = (((int64_t)p9) * (p>>13) * (p>>13)) >> 25;
	  var2 = (((int64_t)p8) * p) >> 19;

	  p = ((p + var1 + var2) >> 8) + (((int64_t)p7)<<4);
	  *pressure = (int32_t)p/256;

	  return 0;
}

float BMP280_ReadAltitude(float sea_level_pa)
{
	  float altitude;

	  float pressure = BMP280_ReadPressure(); // in Si units for Pascal
//	  pressure /= 100;

	  altitude = 44330 * (1.0 - pow(pressure / sea_level_pa, 0.1903));

	  return altitude;
}
#endif
#ifdef BME280
uint8_t BME280_ReadTemperatureAndPressureAndHuminidity(float *temperature, int32_t *pressure, float *huminidity)
{
	int64_t var1, var2, p;

	// Must be done first to get the t_fine variable set up
	*temperature = BME280_ReadTemperature();

	if(*temperature == -99)
	  return -1;

	int32_t adc_P = BME280_Read24(BME280_PRESSUREDATA);
	adc_P >>= 4;

	var1 = ((int64_t)t_fine) - 128000;
	var2 = var1 * var1 * (int64_t)p6;
	var2 = var2 + ((var1*(int64_t)p5)<<17);
	var2 = var2 + (((int64_t)p4)<<35);
	var1 = ((var1 * var1 * (int64_t)p3)>>8) +
			((var1 * (int64_t)p2)<<12);
	var1 = (((((int64_t)1)<<47)+var1))*((int64_t)p1)>>33;

	if (var1 == 0) {
		return 0;  // avoid exception caused by division by zero
	}
	p = 1048576 - adc_P;
	p = (((p<<31) - var2)*3125) / var1;
	var1 = (((int64_t)p9) * (p>>13) * (p>>13)) >> 25;
	var2 = (((int64_t)p8) * p) >> 19;

	p = ((p + var1 + var2) >> 8) + (((int64_t)p7)<<4);
	*pressure = (int32_t)p/256;

	// Pressure section
	int32_t adc_H = BME280_Read16(BME280_HUMIDDATA);
	if (adc_H == 0x8000) // value in case humidity measurement was disabled
		return -1; //error

	int32_t v_x1_u32r;

	v_x1_u32r = (t_fine - ((int32_t)76800));

	v_x1_u32r = (((((adc_H << 14) - (((int32_t)h4) << 20) -
				  (((int32_t)h5) * v_x1_u32r)) + ((int32_t)16384)) >> 15) *
			   (((((((v_x1_u32r * ((int32_t)h6)) >> 10) *
					(((v_x1_u32r * ((int32_t)h3)) >> 11) + ((int32_t)32768))) >> 10) +
				  ((int32_t)2097152)) * ((int32_t)h2) + 8192) >> 14));

	v_x1_u32r = (v_x1_u32r - (((((v_x1_u32r >> 15) * (v_x1_u32r >> 15)) >> 7) *
							 ((int32_t)h1)) >> 4));

	v_x1_u32r = (v_x1_u32r < 0) ? 0 : v_x1_u32r;
	v_x1_u32r = (v_x1_u32r > 419430400) ? 419430400 : v_x1_u32r;
	float h = (v_x1_u32r>>12);
	*huminidity = h / 1024.0;

	return 0;
}

float BME280_ReadAltitude(float sea_level_pa)
{
	  float altitude;

	  float pressure = BME280_ReadPressure(); // in Si units for Pascal
//	  pressure /= 100;

	  altitude = 44330 * (1.0 - pow(pressure / sea_level_pa, 0.1903));

	  return altitude;
}
#endif
