DLedzianowski/badanie-ogniw-projekt-inzynierski/(commit log)

2025-04-06 Initial commit
    SPI: BMP280, OLED, czytnik SD
2025-08-18 stm32 blackpill
2025-09-28 batery ADC, OLED
2025-11-20 test com
    [Sensors1.kicad_sch]
2025-11-22 pcb commit
    [Sensors1.kicad_sch, inz.kicad_sch]
2025-11-26 pcb sensors
    [Sensors1.kicad_sch, Sensors2.kicad_sch, inz.kicad_sch]
2025-11-30 Rough Layout pcb
    [Connectors.kicad_sch, Relays.kicad_sch, Sensors1.kicad_sch, Sensors2.kicad_sch, inz.kicad_pcb, inz.kicad_sch]
2025-12-03 pcb XL4015
    [Sensors1.kicad_sch, Sensors2.kicad_sch, inz.kicad_sch]
2025-12-04 XL4015 CC, relays
    [BatteryLoad.kicad_sch, Connectors.kicad_sch, Fuse Holder.step, Relays.kicad_sch, Sensors1.kicad_sch, Sensors2.kicad_sch, XL4015.kicad_sch, inz.kicad_pcb]
2025-12-07 pcb relay
    [inz.kicad_pcb]
2025-12-07 PCB routing
    [Connectors.kicad_sch, inz.kicad_pcb, inz.kicad_sch]
2025-12-07 PCB final routing
    [BatteryLoad.kicad_sch, Connectors.kicad_sch, Relays.kicad_sch, Sensors1.kicad_sch, XL4015.kicad_sch, inz.kicad_pcb, inz.kicad_sch]
2025-12-08 PCB final design
    [BOM.csv, BatteryLoad.kicad_sch, Connectors.kicad_sch, Relays.kicad_sch, Sensors1.kicad_sch, XL4015.kicad_sch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]
2026-01-09 OLED 2.8, BME, SGP calibration, enc
2026-01-12 oled, sd
    [BatteryLoad.kicad_sch, inz.kicad_pcb, inz.kicad_sch]
2026-01-18 usb, sd
    [BatteryLoad.kicad_sch, Connectors.kicad_sch, Relays.kicad_sch, Sensors1.kicad_sch, XL4015.kicad_sch, inz.kicad_sch]
2026-01-19 sgpAH, relay
