DLedzianowski/badanie-ogniw-projekt-inzynierski/(notices)

Notices in the files:
software/STM32CubeIDE/badanie-ogniw-blackpill/Core/Inc/main.h:
Copyright (c) 2025 STMicroelectronics.
All rights reserved.
This software is licensed under terms that can be found in the LICENSE file
